lm42p/diy/docs/source/ElectricalPart/ElectricalPart.rst

.. # define a hard line break for HTML
.. |br| raw:: html

 <br />

=================
 Electrical Part
=================

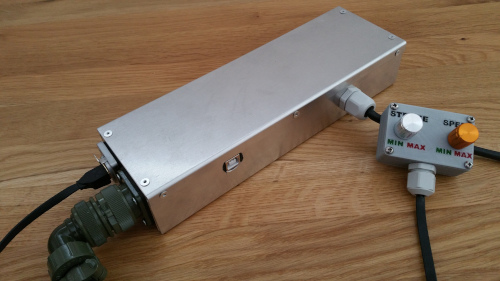
[picture p3: docs/source/ElectricalPart/figures/Power_Control_Unit_And_Remote-DIY-LM42P.jpg]

	    
Electrical Box
==============

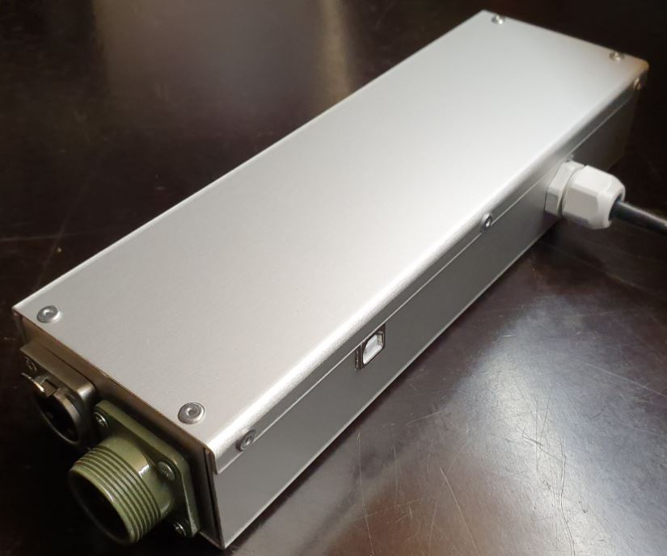
[picture p4: docs/source/ElectricalPart/figures/Electrical-Box-DIY-LM42P.jpg]


.. note::

   There is another Electrical Box which is about 130$ cheaper but
   15-20% slower and 40% less powerful (instead of 29 lbs thrust 17
   lbs) The Box is 3D printed. 

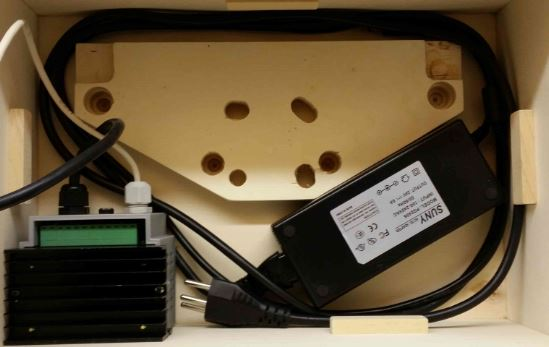
[picture p5: docs/source/ElectricalPart/figures/CheapElectricalBox/Cheap_Electrical_Box-DIY-LM42P.JPG]
    

   Driver : |CheapDriverAliexpress|

   .. |CheapDriverAliexpress| raw:: html

     <a href="https://www.aliexpress.com/item/32659074865.html?spm=a2g0s.9042311.0.0.27424c4dLziSPX"
     target="_blank">Cheap Driver Aliexpress</a>

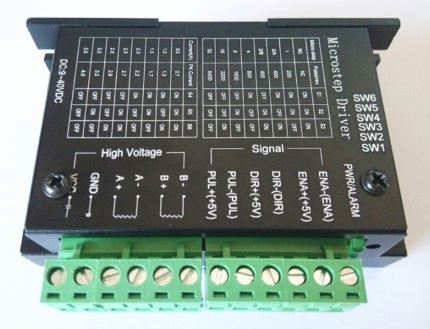
[picture p6: docs/source/ElectricalPart/figures/CheapElectricalBox/Cheap_Driver-Cheap-Electrical-Box-DIY-LM42P.JPG]
   

   Power 24V, 6A : |Power24V6AAliexpress|

   .. |Power24V6AAliexpress| raw:: html

     <a href="https://www.aliexpress.com/item/32589666765.html?spm=a2g0s.9042311.0.0.27424c4dOakSKw"
     target="_blank">Power 24V 6A Aliexpress</a>
     
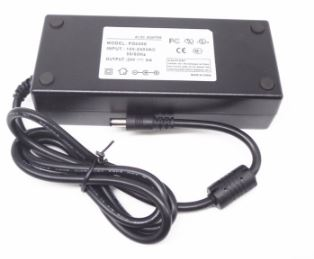
[picture p7: docs/source/ElectricalPart/figures/CheapElectricalBox/Cheap_Power_24V_6A-Cheap-Electrical-Box-DIY-LM42P.JPG]
   

Listing Parts
-------------

U Base
~~~~~~
- Quantity : 1x
- Material : anodized aluminium

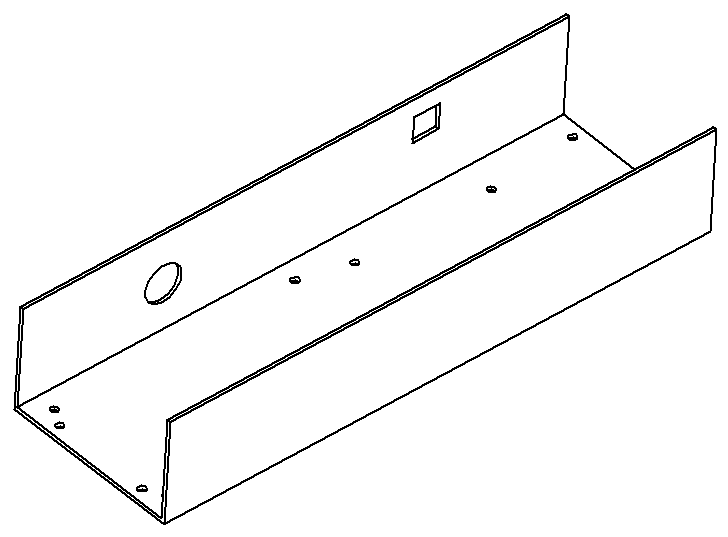
[picture p8: docs/source/ElectricalPart/figures/U_Base-3D-Electrical-Box-DIY-LM42P.PNG]


U Top
~~~~~
- Quantity : 1x
- Material : anodized aluminium

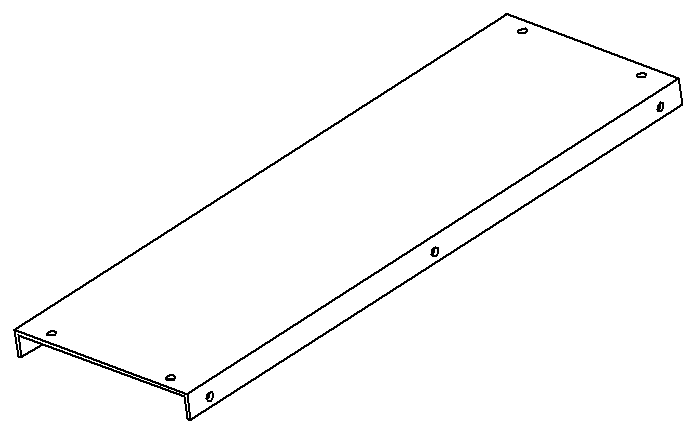
[picture p9: docs/source/ElectricalPart/figures/U_Top-3D-Electrical-Box-DIY-LM42P.PNG]


U Right
~~~~~~~
- Quantity : 1x
- Material : anodized aluminium

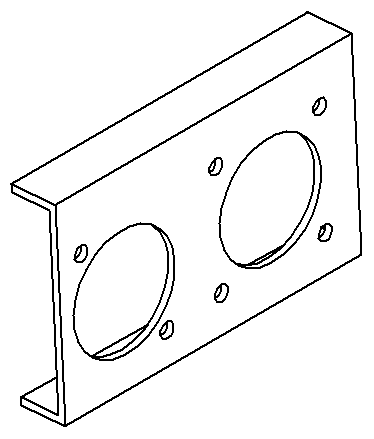
[picture p10: docs/source/ElectricalPart/figures/U_Right-3D-Electrical-Box-DIY-LM42P.PNG]


U Left
~~~~~~
- Quantity : 1x
- Material : anodized aluminium

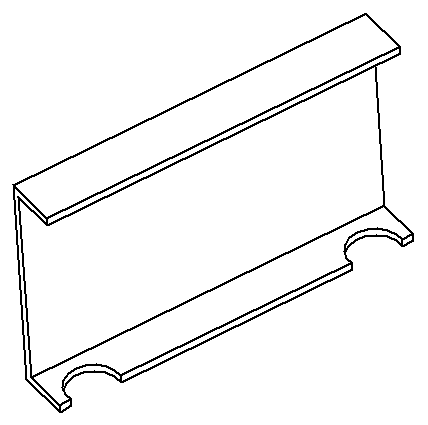
[picture p11: docs/source/ElectricalPart/figures/U_Left-3D-Electrical-Box-DIY-LM42P.PNG]

	    
Geckodrive G201X
~~~~~~~~~~~~~~~~
- Quantity : 1x

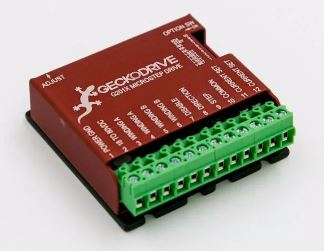
[picture p12: docs/source/ElectricalPart/figures/Geckodrive_G201X-Electrical-Box-DIY-LM42P.jpg]


Arduino Uno
~~~~~~~~~~~
- Quantity : 1x
  
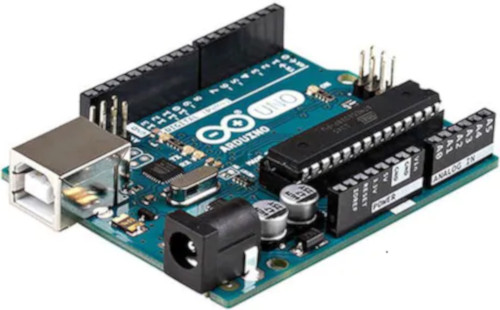
[picture p13: docs/source/ElectricalPart/figures/Arduino_Uno-DIY-LM42P.jpg]


Power 36V
~~~~~~~~~
- Quantity : 1x
  
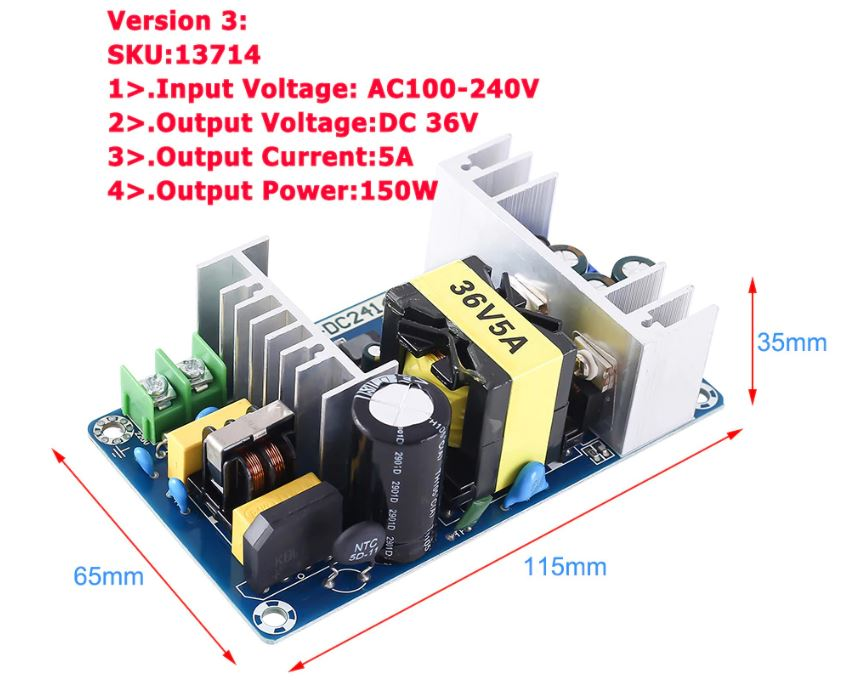
[picture p14: docs/source/ElectricalPart/figures/Power_36V-Electrical-Box-DIY-LM2P.jpg]


Power 36/12V
~~~~~~~~~~~~
- Quantity : 1x
- Type : LM2596

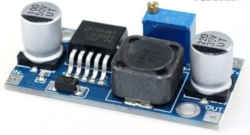
[picture p15: docs/source/ElectricalPart/figures/Power_36_12V-Electrical-Box-DIY-LM42P.JPG]


Connector Socket 5 pins Female Insert
~~~~~~~~~~~~~~~~~~~~~~~~~~~~~~~~~~~~~
- Quantity : 1x
  
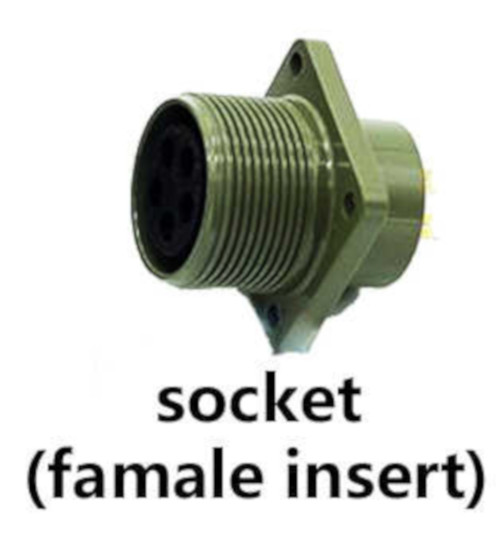
[picture p16: docs/source/ElectricalPart/figures/Socket_5_pins_Female_Insert-Electrical-Box-DIY-LM42P.jpg]


Plug RJ45
~~~~~~~~~
- Quantity : 1x
- Include : 2x screw M3, 2x nuts M3 and 2x spring washer
  
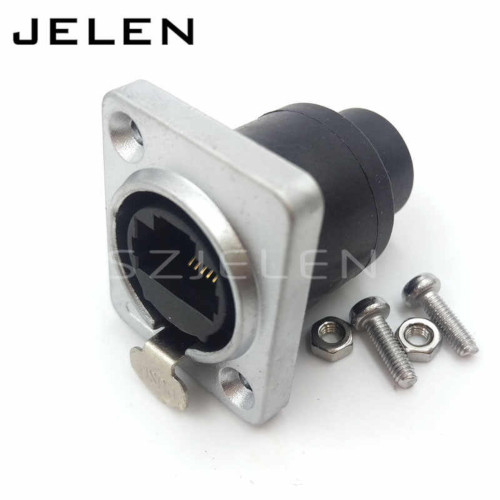
[picture p17: docs/source/ElectricalPart/figures/Plug_RJ45-Electrical-Box-DIY-LM42P.jpg]


Cable Gland
~~~~~~~~~~~
- Quantity : 1x
- Type : M16 4.5-10mm
- Include : 1x nuts M16  

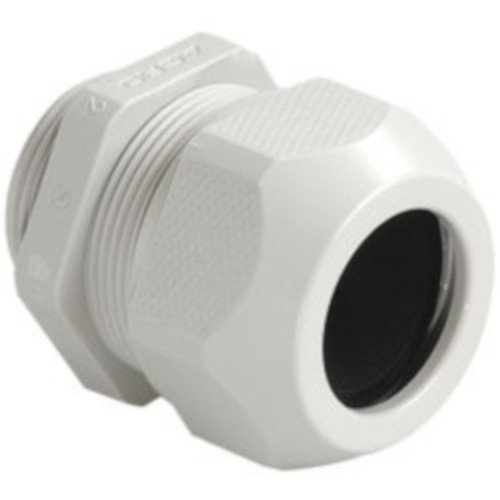
[picture p18: docs/source/ElectricalPart/figures/Cable_Gland_M16_4,5-10mm-Electrical-Box-DIY-LM42P.jpg]


Cable Ties
~~~~~~~~~~

- Quantity : 1x
- Purpose : To be sur that the **Cable Silicone 3 cores** can't be
  pull out

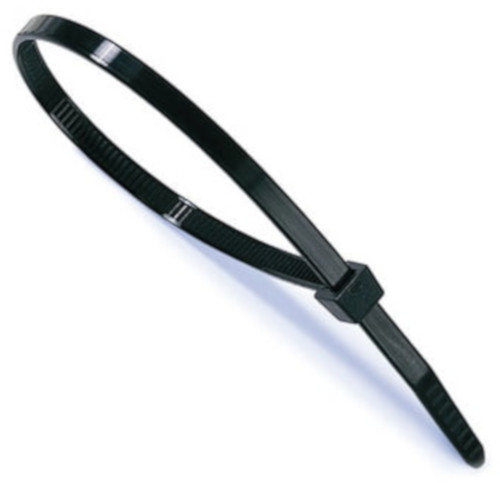
[picture p19: docs/source/ElectricalPart/figures/Cable_Ties-Electrical-Box-DIY-LM42P.jpg]


Cable Silicone 3 Cores
~~~~~~~~~~~~~~~~~~~~~~
- Length : 1x 2m
- Type : 0.75mm^2 
- Note : I used silicone because it's easy to fold.  
	    
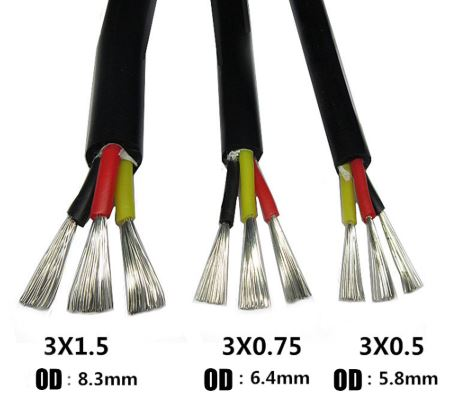
[picture p20: docs/source/ElectricalPart/figures/Cable_Silicone_3_Cores-Electrical-Box-DIY-LM42P.jpg]


Plug 110 / 220 V
~~~~~~~~~~~~~~~~

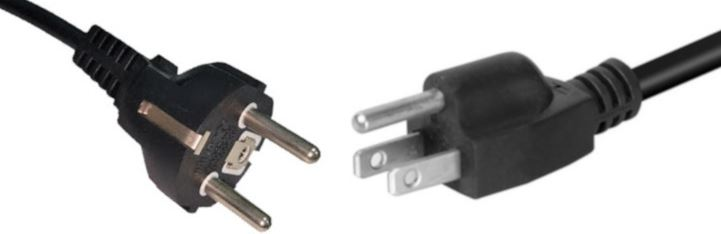
[picture p21: docs/source/ElectricalPart/figures/Plug_110_220V-Electrical-Box-DIY-LM42P.JPG]

	    
Male PCB PIN Header
~~~~~~~~~~~~~~~~~~~
- 1x 15 pins
- 1x 10 pins
- 1x 8 pins

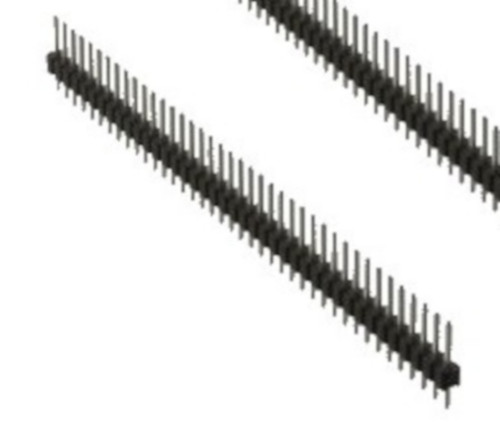
[picture p22: docs/source/ElectricalPart/figures/Male_PCB_PIN_Header-DIY-LM42P.jpg]


Connector RJ45
~~~~~~~~~~~~~~
- Quantity : 1x
- Length : 15cm  

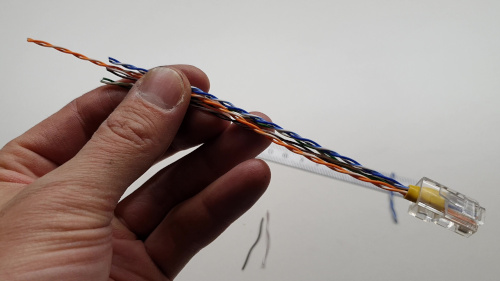
[picture p23: docs/source/ElectricalPart/figures/Connector_RJ45_length_15cm-DIY-LM42P.jpg]


Ground Terminal M3
~~~~~~~~~~~~~~~~~~
- Quantity : 1x

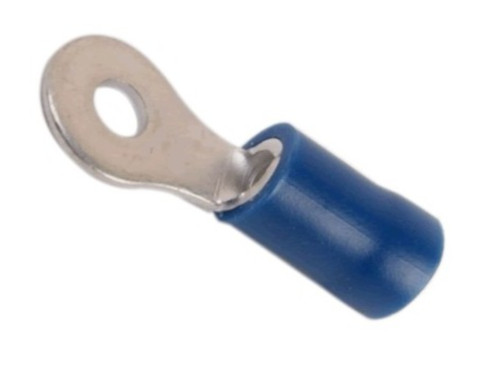
[picture p24: docs/source/ElectricalPart/figures/Ground_Terminal_M3-Electrical-Box-DIY-LM42P.jpg]

	    
Capacitor Polarized 1uF
~~~~~~~~~~~~~~~~~~~~~~~
- Quantity : 1x
- Purpose : This reduce the noise while reading the speed on the
  remote-control

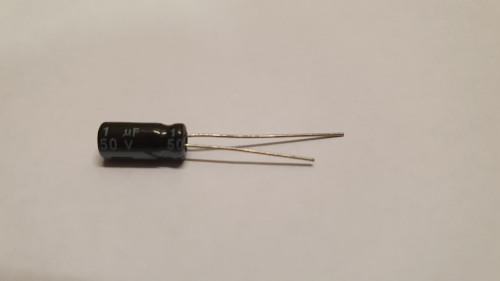
[picture p25: docs/source/ElectricalPart/figures/Capacitor_1uf_polarized-Electrical-Box-DIY-LM42P.jpg]


Spacer 6-8-3mm
~~~~~~~~~~~~~~
- Quantity : 4x
- Material : aluminium

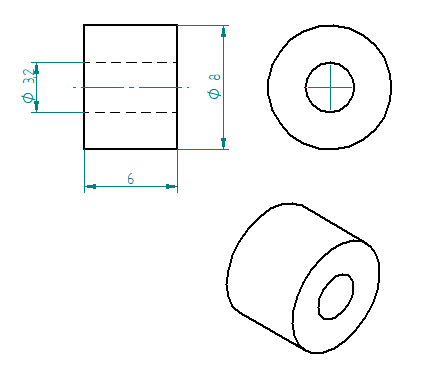
[picture p26: docs/source/ElectricalPart/figures/Spacer_6_8_3mm-Electrical-Box-DIY-LM42P.PNG]


Square 10-12-9mm
~~~~~~~~~~~~~~~~
- Quantity : 2x
- Material : aluminium
- Purpose : Reinforcement of the fixaton (glue) of the **Arduino Uno**
  to the **U Base**   

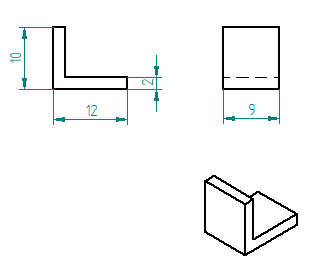
[picture p27: docs/source/ElectricalPart/figures/Square_10_12_9-Electrical-Box-DIY-LM42P.PNG]


Countersunk Head Screw M3 x 8mm
~~~~~~~~~~~~~~~~~~~~~~~~~~~~~~~
- Quantity : 4x
- Material : Stainless Steel
- Purpose : To fix **Geckodrive** on the **U Base**
  
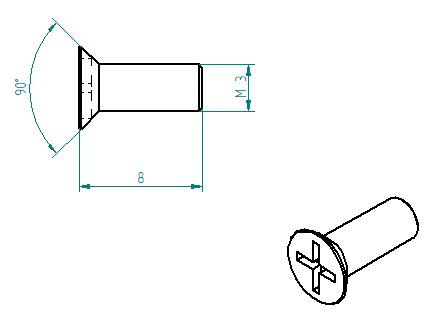
[picture p28: docs/source/ElectricalPart/figures/Countersunk_Head_Screw_M3x8mm-DIY-LM42P.PNG]

	    
Countersunk Head Screw M3 x 12mm
~~~~~~~~~~~~~~~~~~~~~~~~~~~~~~~~
- Quantity : 4x
- Material : Stainless Steel
- Purpose : To fix the **Connector Socket 5 pins Female Insert** on
  the **U Right** 
  
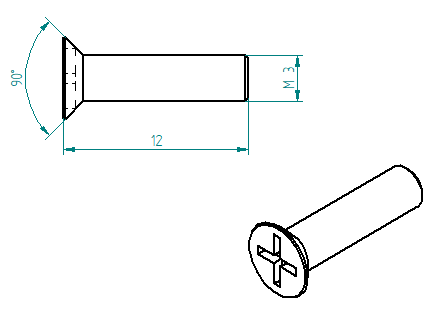
[picture p29: docs/source/ElectricalPart/figures/Countersunk_Head_Screw_M3x12mm-DIY-LM42P.PNG]

	    
Countersunk Head Screw M3 x 14mm
~~~~~~~~~~~~~~~~~~~~~~~~~~~~~~~~
- Quantity : 3x
- Material : Stainless Steel
- Purpose : To fix the **Power 36V** on the **U Base**  

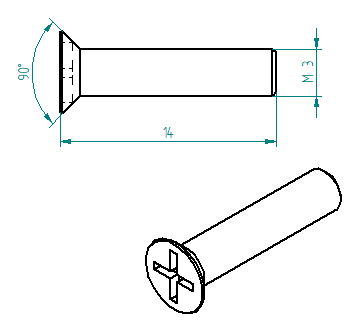
[picture p30: docs/source/ElectricalPart/figures/Countersunk_Head_Screw_M3x14mm-DIY-LM42P.PNG]


Countersunk Head Screw M3 x 16mm
~~~~~~~~~~~~~~~~~~~~~~~~~~~~~~~~
- Quantity : 1x
- Material : Stainless Steel
- Purpose : To fix the **Power 36V** also the **Ground Terminal** on
  the **U Base**  

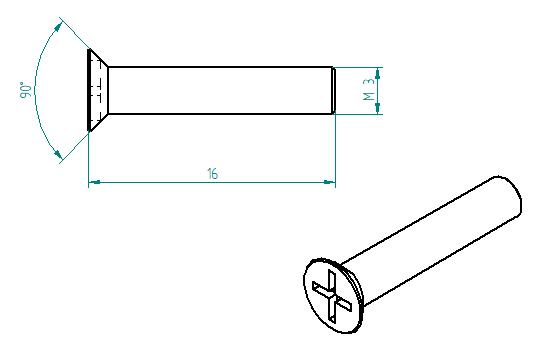
[picture p31: docs/source/ElectricalPart/figures/Countersunk_Head_Screw_M3x16mm-DIY-LM42P.PNG]


Washer M3
~~~~~~~~~
- Quantity : 12x

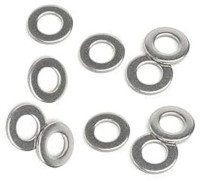
[picture p32: docs/source/ElectricalPart/figures/Washer_M3-Electrical-Box-DIY-LM42P.jpg]


Nuts M3
~~~~~~~
- Quantity : 12x

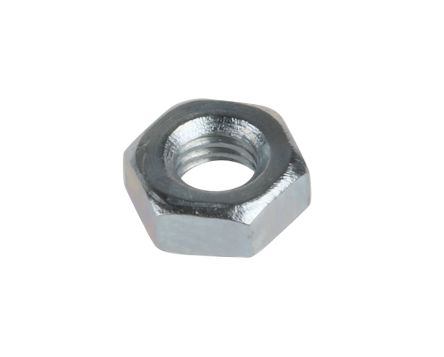
[picture p33: docs/source/ElectricalPart/figures/Nuts_M3-Electrical-Box-DIY-LM42P.jpg]


Rivet
~~~~~
- Quantity : 14x
- Type : diameter 3mm, length 6mm  
- Material : Stainless Steel

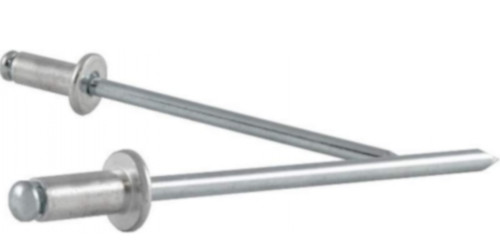
[picture p34: docs/source/ElectricalPart/figures/Rivet_3mm_length_6mm-Electrical-Box-DIY-LM42P.jpg]

	    
Glue Silicone
~~~~~~~~~~~~~
- Quantity : 1x
- Type : Polyflex 444
- Purpose : To glue the **Arduino Uno** to the **U Base** using the
  **Square 10-12-9mm** to fix stronger
  
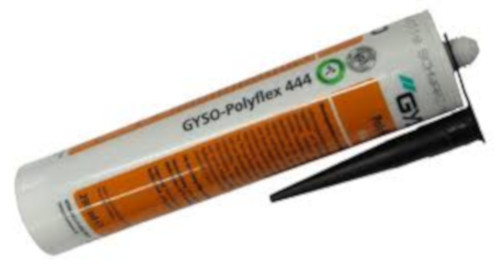
[picture p35: docs/source/ElectricalPart/figures/Glue_Mastic_Polyflex_444-Electrical-Box-DIY-LM42P.jpg]


Threadlocker Glue
~~~~~~~~~~~~~~~~~
- Quantity : 1x
- Type : Loctite 243
- Purpose : To glue the **Nuts M3**
  
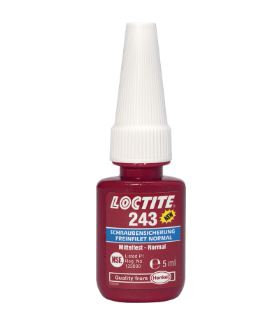
[picture p36: docs/source/ElectricalPart/figures/Threadlocker_Glue-Electrical-Box-DIY-LM42P.JPG]


Operation Plan
--------------

Make The Sheets Parts
~~~~~~~~~~~~~~~~~~~~~

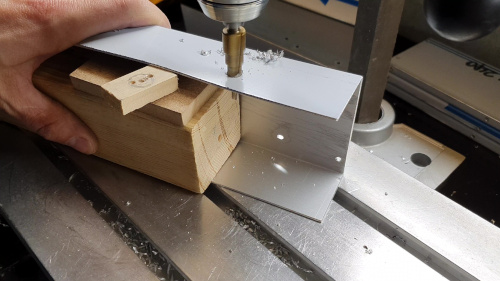
[picture p37: docs/source/ElectricalPart/figures/Make_The_Sheets_Parts-Electrical-Box-DIY-LM42P.jpg]

	    
Make the **U Base**, **U Right** and the **U Left** following this
**Video**, see also the drawings below : 

.. raw:: html

    <iframe width="350" height="245"
    src="https://www.youtube.com/embed/RGeVY6nWUIQ?start=0&end=1078"
    frameborder="0" 
    allowfullscreen></iframe>

|br|

**Drawings** :

Material : aluminium

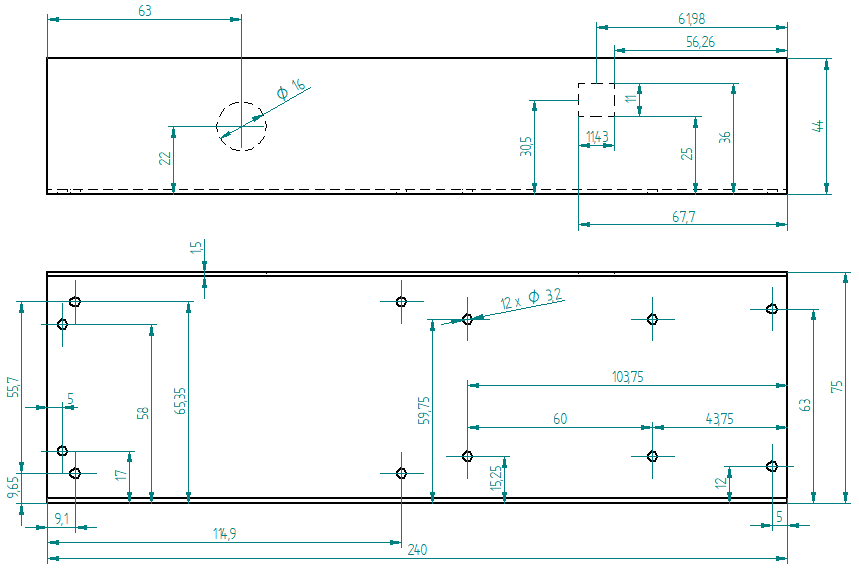
[picture p38: docs/source/ElectricalPart/figures/U_Base-Drawing-Electrical-Box-DIY-LM42P.PNG]


    U Base

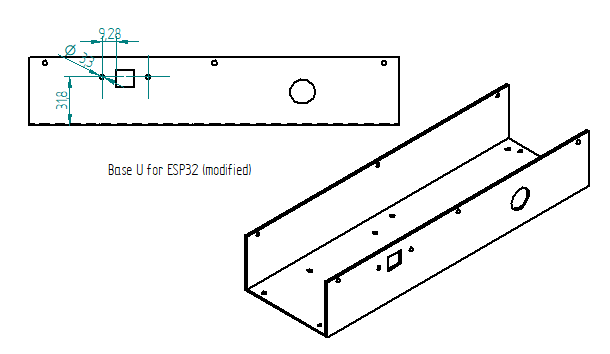
[picture p39: docs/source/ElectricalPart/figures/UbaseESP32Modified/UBaseESP32Modified.PNG]


    U Base ESP (modified)    

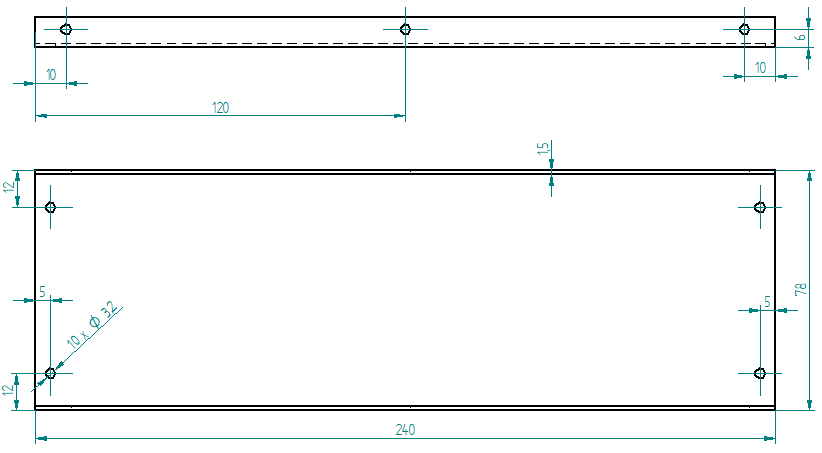
[picture p40: docs/source/ElectricalPart/figures/U_Top-Drawing-Electrical-Box-DIY-LM42P.PNG]


    U Top

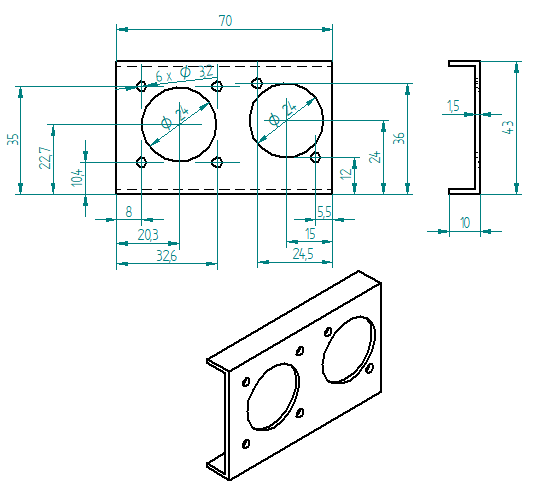
[picture p41: docs/source/ElectricalPart/figures/U_Right-Drawing-Electrical-Box-DIY-LM42P.PNG]


    U Right

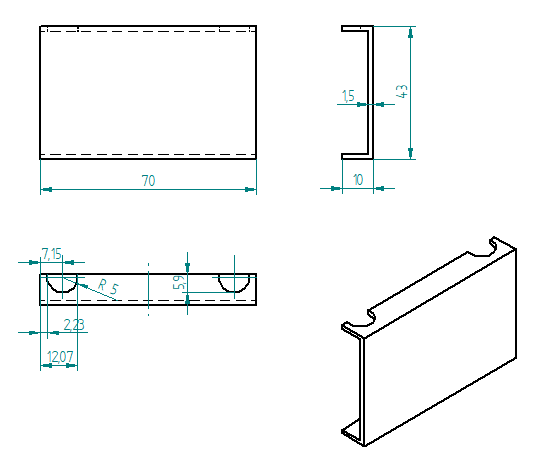
[picture p42: docs/source/ElectricalPart/figures/U_Left-Drawing-Electrical-Box-DIY-LM42P.PNG]


    U Left   

Make the Spacer 6-8-3mm
~~~~~~~~~~~~~~~~~~~~~~~
See the following video :

.. raw:: html

    <iframe width="350" height="245"
    src="https://www.youtube.com/embed/RGeVY6nWUIQ?start=1025&end=1275"
    frameborder="0" 
    allowfullscreen></iframe>

|br|

**Drawing** :

- Quantity : 4x
- Material : aluminium



    Spacer 6-8-3mm

Make the Square 10-12-9mm
~~~~~~~~~~~~~~~~~~~~~~~~~
See the following video :

.. raw:: html

    <iframe width="350" height="245"
    src="https://www.youtube.com/embed/RGeVY6nWUIQ?start=1276&end=1356"
    frameborder="0" 
    allowfullscreen></iframe>

|br|

**Drawing** :

- Quantity : 2x
- Material : aluminium



    Square 10-12-9mm        

Scrape the surface on the U Base
~~~~~~~~~~~~~~~~~~~~~~~~~~~~~~~~

File the bottom of the **U Base** (only the part where the red framed
hole is) so that the grounding contact faces well. This operation is
not necessary if you are using non anodized sheets.

.. note:: The anodized surfaces are not
	  conductive.  

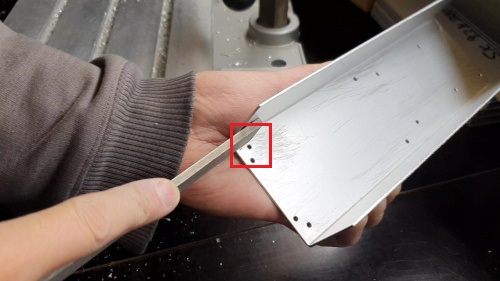
[picture p43: docs/source/ElectricalPart/figures/Scrape_Surface_U_Base-Electrical-Box-DIY-LM42P.jpg]


See Video :

.. raw:: html

    <iframe width="350" height="245"
    src="https://www.youtube.com/embed/RGeVY6nWUIQ?start=152&end=173"
    frameborder="0" 
    allowfullscreen></iframe>

|br|

Control Power 36V
~~~~~~~~~~~~~~~~~
Control the voltage of the output of the Power 36V with a
voltmeter. It should be 36V.

Adjust voltage Power 36/12V
~~~~~~~~~~~~~~~~~~~~~~~~~~~

**Materials:**

* 1 wire 0.5mm^2 red length = 120mm
* 1 wire 0.5mm^2 red length = 150mm
* 1 wire 0.5mm^2 black length = 140mm
* 1 wire 0.5mm^2 black length = 60mm

1) Sold the wire

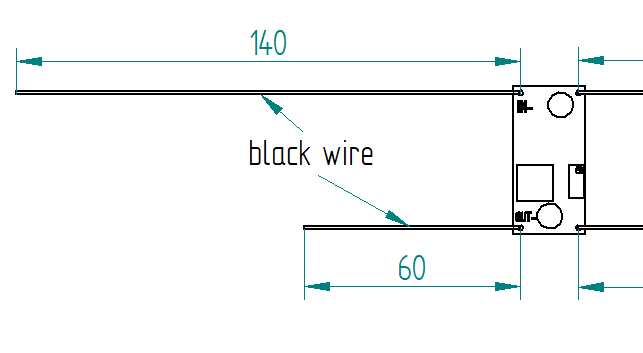
[picture p44: docs/source/ElectricalPart/figures/Power36_12V-Black-Wired-Electrical-Box-LM42P.PNG]


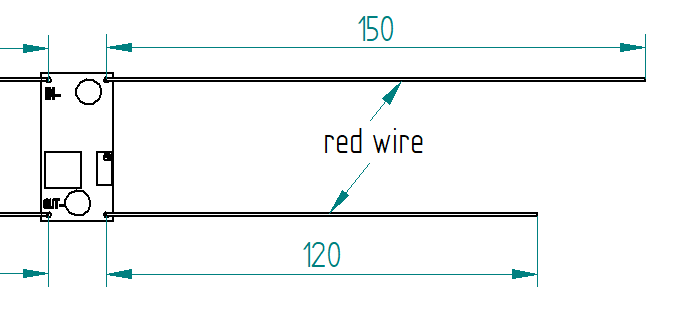
[picture p45: docs/source/ElectricalPart/figures/Power36_12V-Red-Wired-Electrical-Box-LM42P.PNG]


2) Wire the Power 36/12V

 - Connect the Power 36/12V IN  to the Power 36V OUT
 - Connect the voltmeter to Power 36/12V OUT

3) Adjust the voltage

 With a *Screwdriver 0*, adjust the voltage to 12V

Fix the Power Cable to the Electrical Box
~~~~~~~~~~~~~~~~~~~~~~~~~~~~~~~~~~~~~~~~~

See Video :

.. raw:: html

    <iframe width="350" height="245"
    src="https://www.youtube.com/embed/RGeVY6nWUIQ?start=1355&end=1581"
    frameborder="0" 
    allowfullscreen></iframe>

#. Strip the **Cable Silicone 3 Cores** at 10cm 
#. Fix the **Cable Gland** to the **U Base**
#. Tighten **Cable Gland**
#. Tighten the **Cable Ties** and cut it with a *Cutting Pliers*
#. Tighten the **Ground Terminal M3** on the ground wire (yellow)
#. Tighten the Phase and Neutre to **Power 36V** "IN"

Set Geckodrive current limit
~~~~~~~~~~~~~~~~~~~~~~~~~~~~

This operation limits the current so that the motor will not overheat.
I tested with 5A and it looks like the motor is a bit overheaten. But
thats ok if the machine is used less than about 10min. To be sure the
motor is not overheaten I recommand to set the current at 4.2Amps.

- For G203V :

  Connect a resistor of 120kOhms between pin 11 and 12 of the 
  GECKODRIVE. This will limit MOTOR current by 5A. (for 4.2A please
  refer to datasheet)

- For G201X :

  - if machine used for less than 10min set to 5A

    set the switches like the following figure

    

  - if machine used more than 10min set to 4.2A

    set the switches like the following figure

    
   
Screw the Power 36V and Geckodrive on the U Base
~~~~~~~~~~~~~~~~~~~~~~~~~~~~~~~~~~~~~~~~~~~~~~~~

.. note:: Use **Threadlocker Glue**.

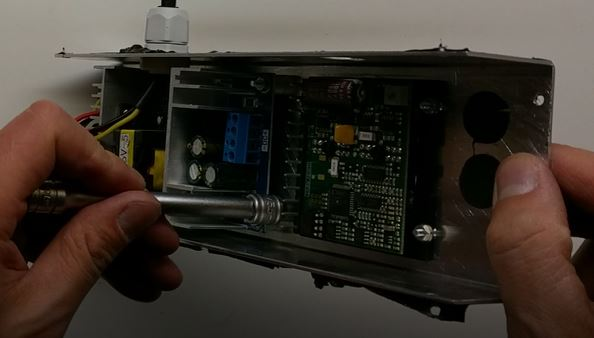
[picture p46: docs/source/ElectricalPart/figures/Fix_Power36V_Gecko-Electrical-Box-DIY-LM42P.jpg]


- For Power 36V :
  
  #. Fix three corners of the **Power 36V** by using :
       * 3x **Spacer 6-8-3mm**
       * 3x **Countersunk Head Screw M3 x 14mm**
       * 3x **Washer M3**
       * 3x **Nuts M3**
  #. Fix the last corner : The ground to the U Base by using : 
       * 1x **Countersunk Head Screw M3 x 16mm**
       * 1x **Washer M3**
       * 1x **Nuts M3**
       * 1x **Ground Terminal M3** (the ground on the **Cable Silicone 3
         Cores** 

    =========  ===================    
    Power 36V  U Base
    =========  ===================
    GROUND     screw with *Spacer*
    =========  ===================

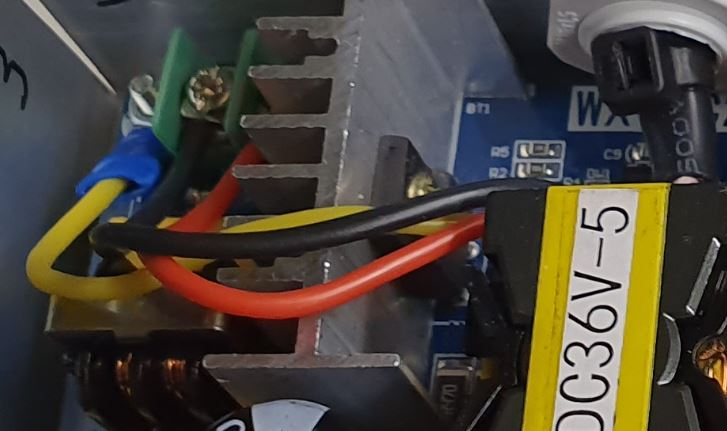
[picture p47: docs/source/ElectricalPart/figures/Power36V_Ground_Electrical-Box-DIY-LM42P.jpg]
    
  
- For Geckodrive use :

  - 4x **Head Screw M3 x 8mm**
  - 4x **Washer M3**
  - 4x **Nuts M3**

Glue the Power 36/12V and Arduino Uno
~~~~~~~~~~~~~~~~~~~~~~~~~~~~~~~~~~~~~

Glue the **Arduino Uno** at the **U Base** with **Glue Silicone** and
**Square 10-12-9mm** and the **Power 36/12V**. 
 
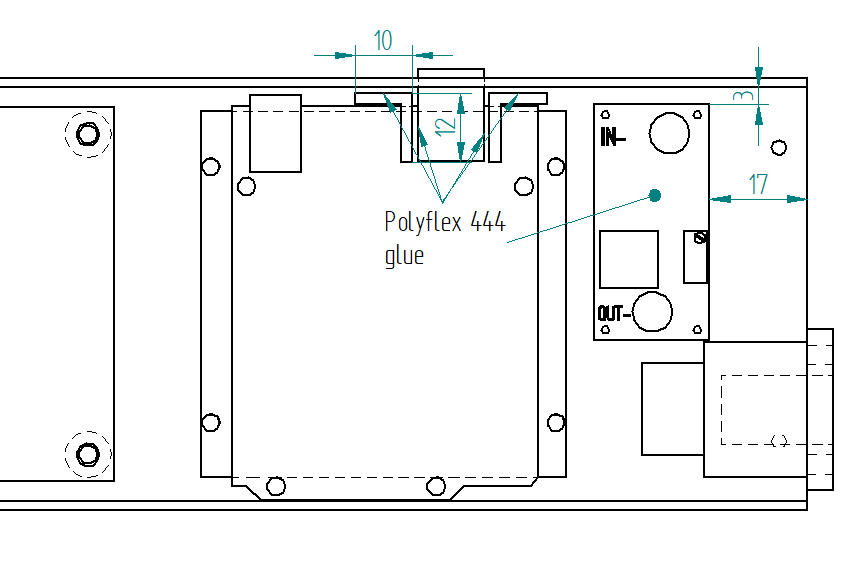
[picture p48: docs/source/ElectricalPart/figures/Glue_Power36_12V_Arduino-Electrical-Box-DIY-LM42P.PNG]


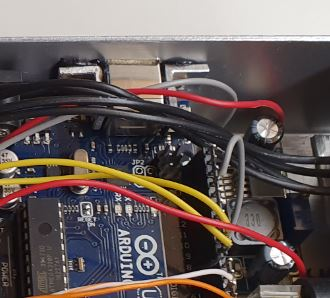
[picture p49: docs/source/ElectricalPart/figures/Glue_Power36_12V_Arduino-Electrical-Box-DIY-LM42P.jpg]


Wiring
~~~~~~
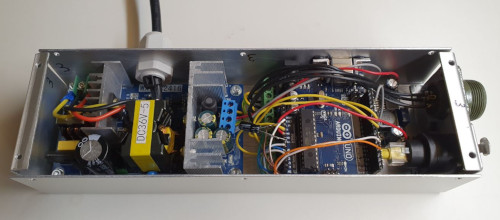
[picture p50: docs/source/ElectricalPart/figures/Electrical_Box_Open-DIY-LM42P.jpg]


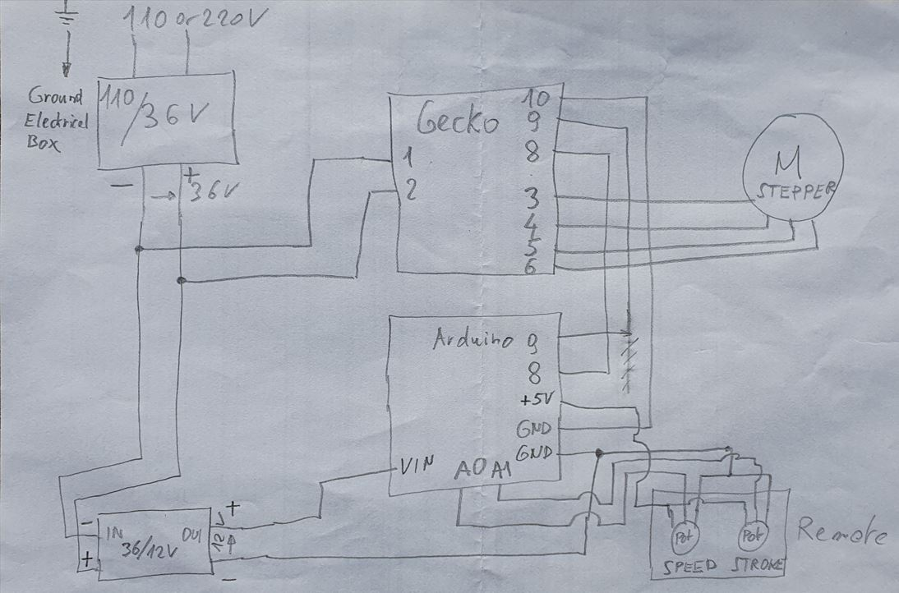
[picture p51: docs/source/ElectricalPart/figures/Shagmatic-Arduino-Gecko-LM42P.JPG]


See video :

.. raw:: html

    <iframe width="350" height="245"
    src="https://www.youtube.com/embed/RGeVY6nWUIQ?start=1581&end=1806"  
    frameborder="0" 
    allowfullscreen></iframe>
    
|br|

1. Sold the wires to the **Male PCB PIN Header** (15, 10, 8 pins),
   except the POWER 36/12V OUT+ 

   Use two clamps this help to sold the **Male PCB PIN Header**

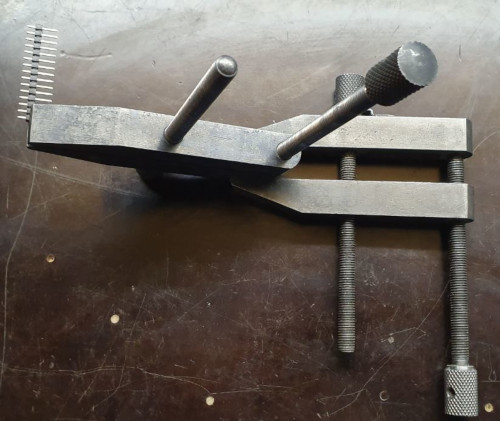
[picture p52: docs/source/ElectricalPart/figures/Clamps_Sold-Electrical-Box-DIY-LM42P.jpg]


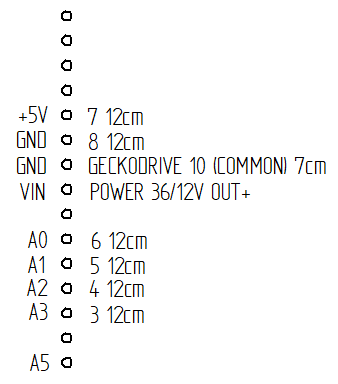
[picture p53: docs/source/ElectricalPart/figures/Male_PCB_PIN_Header_15Pins-Electrical-Box-DIY-LM42P.PNG]


 Male PCB PIN Header 15 pins
	 
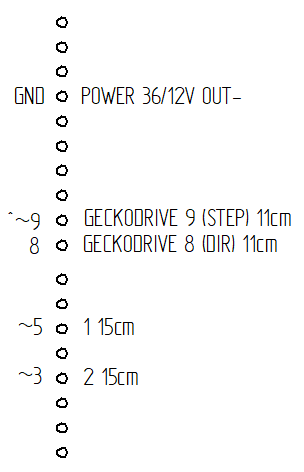
[picture p54: docs/source/ElectricalPart/figures/Male_PCB_PIN_Header_10_8Pins-Electrical-Box-DIY-LM42P.PNG]


 Male PCB PIN Header 10 and 8 pins
	 
===========  =======  ============
GECKODRIVE   ARDUINO  Cable Length
===========  =======  ============
8 (DIR)      PIN 8    11cm
9 (STEP)     PIN 9    11cm
10 (COMMON)  GND       7cm
===========  =======  ============

============  =======  ============
POWER 36/12V  ARDUINO  Cable Length
============  =======  ============
OUT-          GND      6cm
OUT+          VIN      12cm
============  =======  ============

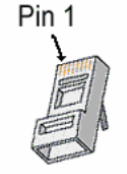
[picture p55: docs/source/ElectricalPart/figures/RJ45_Show_Pin1-Electrical-Box-DIY-LM42P.png]


============  =======================  ============
ARDUINO       RJ45 cable (inside Box)  Cable Length
============  =======================  ============
A0            6 sold capacitor +       12cm     
A1            5                          "
A2            4                          "
A3            3                          "
\~3           2                        15cm 
~5            1                          " 
GND           8 sold capacitor -       12cm
\+5V          7                          "
============  =======================  ============

2. Sold the Capacitor between A0 and GND (8) see folowing picture

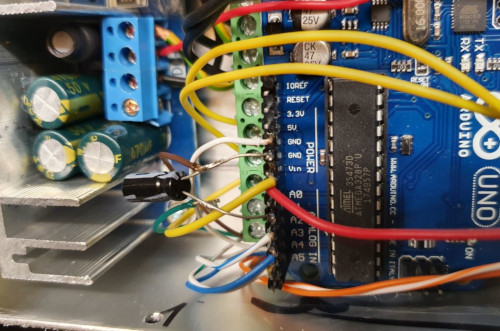
[picture p56: docs/source/ElectricalPart/figures/Sold_Capacitor-Electrical-Box-DIY-LM42P.jpg]


3. Connect :

=========  ================  ============
Power 36V     GECKODRIVE     Cable Length
=========  ================  ============
\-DC       1 (POWER GND)     6cm
D+         2 (18 TO 80 VDC)   "
=========  ================  ============

=========  ============  ============
Power 36V  POWER 36/12V  Cable Length            
=========  ============  ============
\-DC       IN-           14cm 
DC+        IN+           15cm  
=========  ============  ============

=================  ========================  ============
GECKODRIVE         Female Connector (MOTOR)  Cable Length
=================  ========================  ============
3 (WINDING A)      A                         15cm
4 (WINDING not A)  B                          "
5 (WINDING B)      C                          "
6 (WINDING not B)  D                          "
=================  ========================  ============

Upload the programm to **Arduino Uno** and final control
~~~~~~~~~~~~~~~~~~~~~~~~~~~~~~~~~~~~~~~~~~~~~~~~~~~~~~~~
#. Plug the PC using an USB cable to the Electrical-Box
#. Upload the programm (soon available)
#. Control if every thing is ok (the ***Machine**, **Remote Control**,
   **Stepper Motor** and the **Rod** should be done). Do all these
   steps showed in that video for the test :  

   .. raw:: html

    <iframe width="350" height="245"
    src="https://www.youtube.com/embed/VgY4AlmjkgQ"
    frameborder="0" 
    allowfullscreen></iframe>
#. Cover with **U Top** and **Rivet**
    
Remote Control
==============

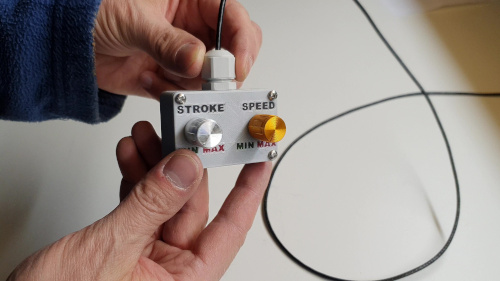
[picture p57: docs/source/ElectricalPart/figures/Remote-Control/Remote_Control_And_Wire_Remote-Control-DIY-LM42P.jpg]


Listing Parts
-------------

Box
~~~
- Quantity : 1x
- 3D Printed in PLA  

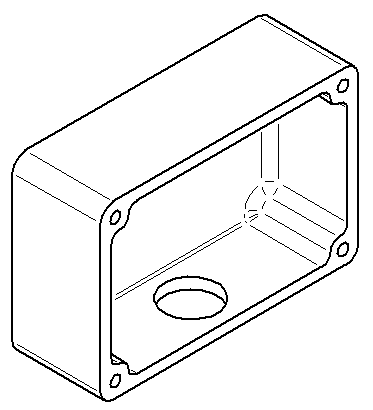
[picture p58: docs/source/ElectricalPart/figures/Remote-Control/Box-3D-Remote-Control-Box-DIY-LM42P.png]


Cover
~~~~~
- Quantity : 1x
- 3D Printed in PLA  

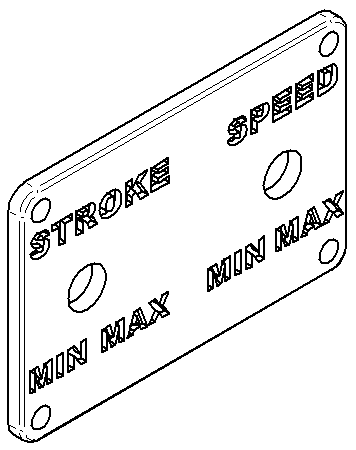
[picture p59: docs/source/ElectricalPart/figures/Remote-Control/Cover-3D-Remote-Control-Box-DIY-LM42P.png]


Potentiometer
~~~~~~~~~~~~~
- Quantity : 2x
- Type : 10k

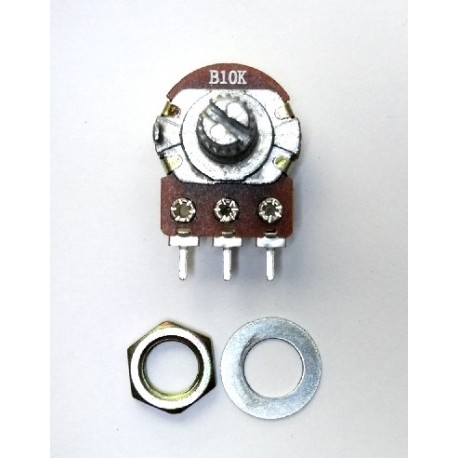
[picture p60: docs/source/ElectricalPart/figures/Remote-Control/Potentiometer_R10k-Remote-Control-Box-DIY-LM42P.jpg]

	    
Potentiommeter Knobs
~~~~~~~~~~~~~~~~~~~~
- Quantity : 1x Grey (stroke), 1x Gold (speed)
  
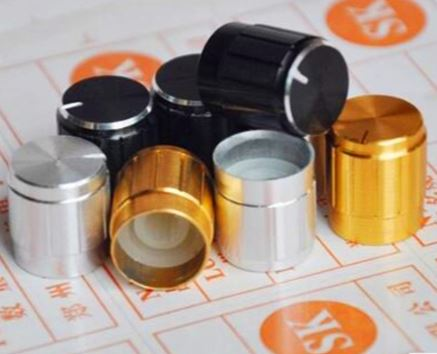
[picture p61: docs/source/ElectricalPart/figures/Remote-Control/Potentiometer_Knobs-Remote-Control-Box-LM42P.JPG]


RJ45 Cable
~~~~~~~~~~
- Quantity : 1x
- Length : 2.5m  
- Type : Ultrafine

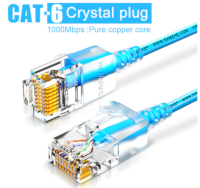
[picture p62: docs/source/ElectricalPart/figures/Remote-Control/RJ45_Cable-Remote-Control-Box-DIY-LM42P.PNG]

	    	    
Cable Gland M12
~~~~~~~~~~~~~~~
- Quantity : 1x
- Type : M12 3-6mm

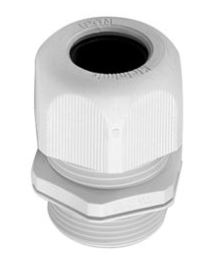
[picture p63: docs/source/ElectricalPart/figures/Remote-Control/Cable_Gland_M12-Remote-Control-Box-DIY-LM42P.JPG]


Epoxy
~~~~~
- Resin and Hardener

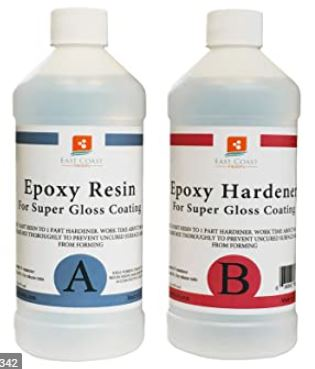
[picture p64: docs/source/ElectricalPart/figures/Remote-Control/Epoxy_Resin-Remote-Control-Box-DIY-LM42P.JPG]


Pigment Epoxy
~~~~~~~~~~~~~
- Quantity : 1x color black, 1x color red, 1x color green

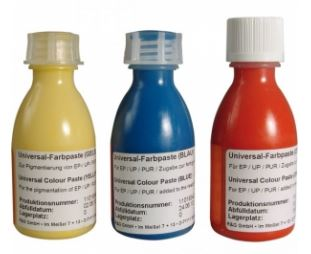
[picture p65: docs/source/ElectricalPart/figures/Remote-Control/Pigments_Epoxy-Remote-Control-Box-DIY-LM42P.JPG]


Cable Ties
~~~~~~~~~~

- Quantity : 1x
- Purpose : To be sur that the **RJ45 Cable** can't be
  pull out



Screw
~~~~~
- Quantity : 4x
- Diameter : 2.9mm
- Length : 13mm
- Stainless steel

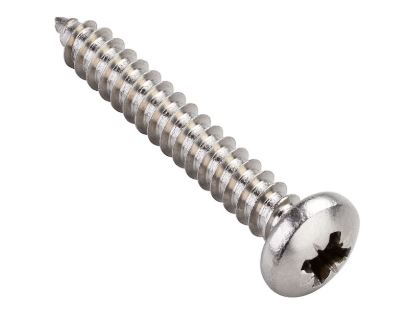
[picture p66: docs/source/ElectricalPart/figures/Remote-Control/Scew_2_9_13-Remote-Control-Box-DIY-LM42P.JPG]


Operation Plan
--------------
See the video :

.. raw:: html

    <iframe width="350" height="245"
    src="https://www.youtube.com/embed/wxmEBM34qhU"
    frameborder="0" 
    allowfullscreen></iframe>

|br|

Make the Box
~~~~~~~~~~~~
Print it in PLA.
Infill = 50%
File : soon available...

Make the Cover
~~~~~~~~~~~~~~
1. Print it in PLA.
   Infill = 50%
   File : soon available...  
2. Prepare the **Epoxy** with black pigment, red pigment and green
   pigment 
3. Fill with pigmented Epoxy the inscriptions on the **Cover**

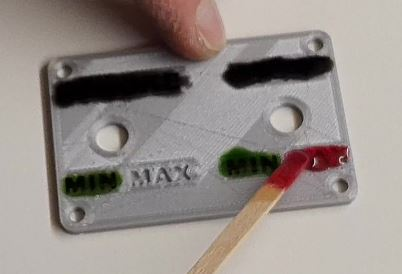
[picture p67: docs/source/ElectricalPart/figures/Remote-Control/Fill_Inscriptions_Pigmented_Epoxy-Remote-Control-Box-DIY-LM42P.JPG]
     
	   
4. Cure the **Epoxy** then sand it very thin (60, 240, 400)
5. Place the **Potentiometer** (2x) and and tighten them   

Wiring the Remote Control
~~~~~~~~~~~~~~~~~~~~~~~~~
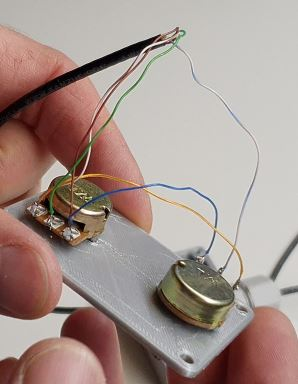
[picture p68: docs/source/ElectricalPart/figures/Remote-Control/Wire-Remote-Control-Box-DIY-LM42P.JPG]


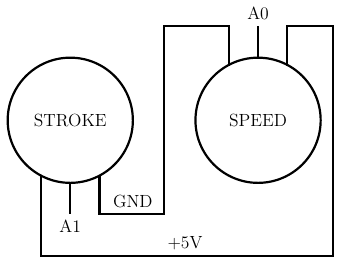
[picture p69: docs/source/ElectricalPart/figures/Remote-Control/Remote_Control_Box_Wiring-Remote-Control-Box-DIY-LM42P.png]


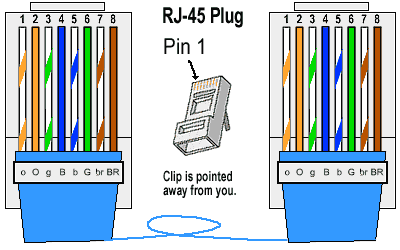
[picture p70: docs/source/ElectricalPart/figures/Remote-Control/Standard_Ethernet_Cable_RJ45.gif]

	   
==============  ===========  ============
Remote-Control   RJ45 cable   Wire Color
==============  ===========  ============
A0              6            G
A1              5            b
GND             8            BR
\+5V            7            br
==============  ===========  ============

#. Strip the **RJ45 Cable** at 7cm
#. Cut the unused wire
#. Use the cutted unused wire to make the bridge between GRD and +5V
   inside the Remote Control

Motor
=====

This section shows how to fix the **Cable Silicone 4 Cores** to the **Connector
Plug 5 pins Male Insert** and the **Motor**

Listing Parts
-------------

Motor
~~~~~
- Quantity : 1x
- Type : Stepper Motor NEMA 23 23HS11240
- Length : 112mm
- 4.2A  

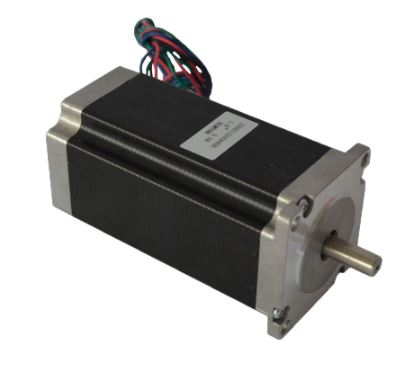
[picture p71: docs/source/ElectricalPart/figures/Motor/Stepper_Motor_23HS11240-Motor-DIY-LM42P.JPG]


Connector Plug 5 pins Male Insert
~~~~~~~~~~~~~~~~~~~~~~~~~~~~~~~~~
- Quantity : 1x

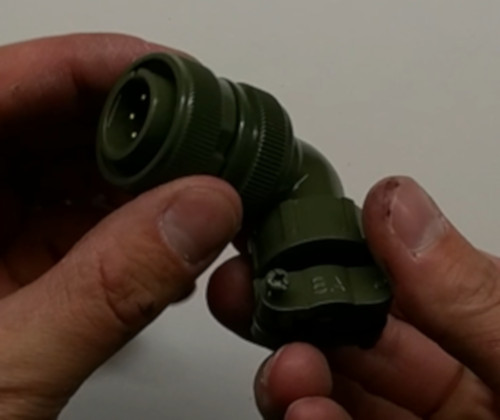
[picture p72: docs/source/ElectricalPart/figures/Motor/Connector_Plug_5_pins_Male_Insert-Electrical-Box-DIY-LM42P.jpg]


Cable Silicone 4 Cores
~~~~~~~~~~~~~~~~~~~~~~
- Quantity : 2.2m
- 0.75 mm^2  

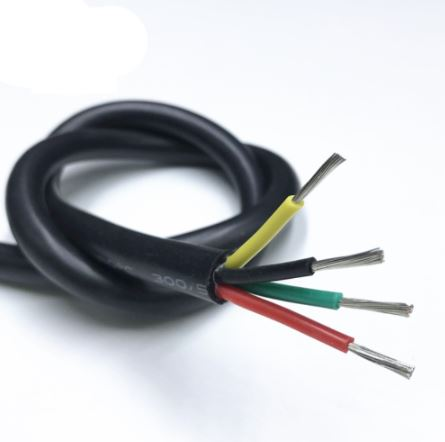
[picture p73: docs/source/ElectricalPart/figures/Motor/Cable_Silicone_4_Cores-Motor-DIY-LM42P.jpg]


Tube Cable Holder
~~~~~~~~~~~~~~~~~
- Quantity : 1x
- Material : Aluminium  

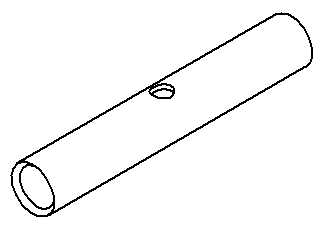
[picture p74: docs/source/ElectricalPart/figures/Motor/Tube_Cable_Holder-Motor-DIY-LM42P.PNG]


Heat Shrink Tube
~~~~~~~~~~~~~~~~
- Quantity : 4x - Length : 13mm
- Quantity : 1x - Length : 37mm


  
Screw Hex Head Allen M5 x 40
~~~~~~~~~~~~~~~~~~~~~~~~~~~~
If the **Motor** isn't fixed yet on the **Machine**, then 1x Screw is
needed.

- Quantity : 1x
- Size : M5 x 40  
- Type : Stainless Allen Bolt Socket Cap Screw Hex Head Allen Key
  DIN912 

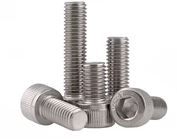
[picture p75: docs/source/ElectricalPart/figures/Motor/Screw_Hex_Head_Allen_M5x40-Motor-DIY-LM42P.JPG]

	    
Glue Silicone
~~~~~~~~~~~~~
- Quantity : 1x
- Type : Polyflex 444
  


Cable Ties
~~~~~~~~~~

- Quantity : 1x



Connect the Connector Plug 5 pins Male Insert
---------------------------------------------
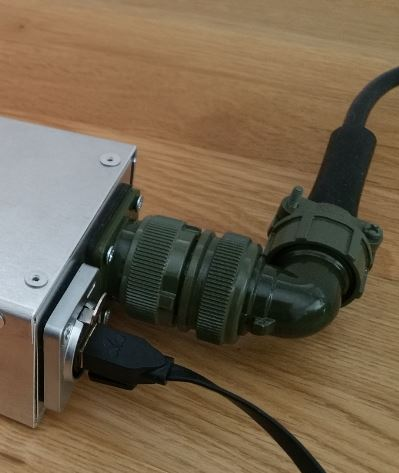
[picture p76: docs/source/ElectricalPart/figures/Motor/Connector_Plug_5_pins_Male_Insert-Motor-DIY-LM42P.JPG]


Operation Plan
~~~~~~~~~~~~~~
See the video :

.. raw:: html

    <iframe width="350" height="245"
    src="https://www.youtube.com/embed/GfWPj4LcxXg?start=0&end=97"
    frameborder="0" 
    allowfullscreen></iframe>

|br|

Wiring

#. strip the cable at 3cm
#. strip the 4 wires and solder the wires
#. 5cm from the edge roll up the 10-layers adhesive tape
#. pass the cable and solder the wires in the plug in
   counter-clockwise order 
   
   * black (A)
   * yellow (B)
   * red (C)
   * green (D)

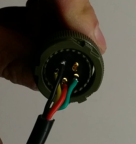
[picture p77: docs/source/ElectricalPart/figures/Motor/Wires_Plug-Motor-DIY-LM42P.png]
   
	    
#. assemble the plug and tighten the flange

Connect and fix the Cable Silicone 4 Cores to the Motor
-------------------------------------------------------
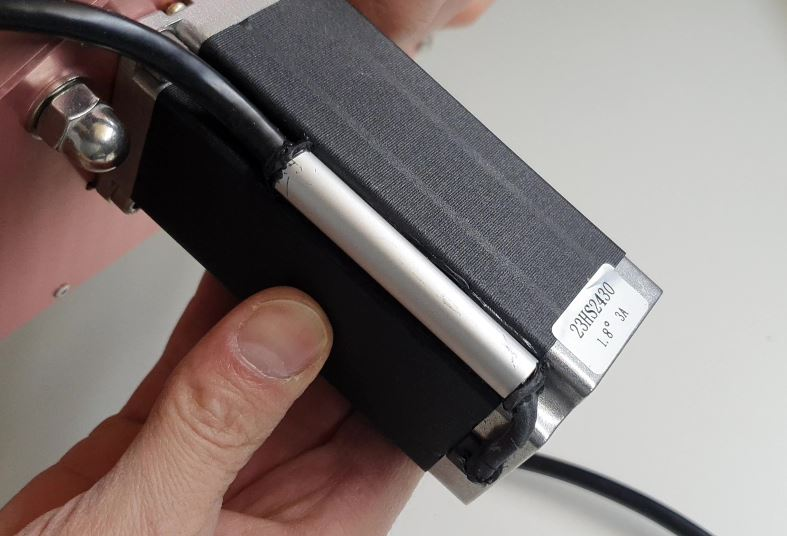
[picture p78: docs/source/ElectricalPart/figures/Motor/Connect_Motor_Cable-DIY-LM42P.jpg]


Operation Plan
~~~~~~~~~~~~~~
See the video :

.. raw:: html

    <iframe width="350" height="245"
    src="https://www.youtube.com/embed/GfWPj4LcxXg?start=97&end=417"
    frameborder="0" 
    allowfullscreen></iframe>

|br|	    

#. Make the **Tube Cable Holder**

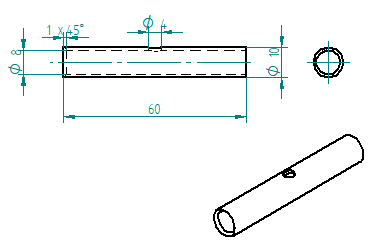
[picture p79: docs/source/ElectricalPart/figures/Motor/Tube_Cable_Holder-Drawing-Motor-DIY-LM42P.PNG]
   

     Tube Cable Holder (material aluminium anodized)

#. Unpacking and motor control. Plug the 4 wires on an **Electrical
   Box** and make it turn. This is important before making the
   following steps.
#. There are two kinds of motor a 3A and a 4.2A each motor has their own
   colors of wire. Depend on the Amps of the motor you use, cut the
   wire as follow :
   
   #. Motor 3A :
      
      - red wire 47mm
      - yellow 57mm
      - blue 67mm
      - green 77mm
	
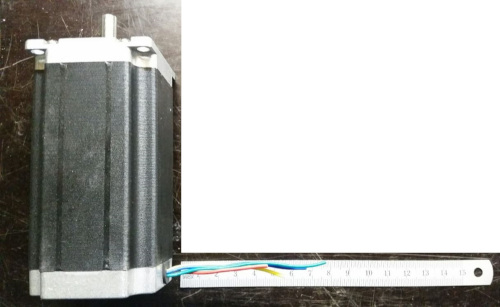
[picture p80: docs/source/ElectricalPart/figures/Motor/Cut_Motor_Wire-Motor-DIY-LM42P.jpg]
      

	3A motor with wires cutted 

   #. Motor 4.2A :
      
      - red 47mm
      - green 57mm
      - black 67mm
      -	blue 77mm
	
#. Stripping, twisting, tinning the motor wires to 5mm
#. Cut the **Heat Shrink Tube** to 37mm length and tighten it with
   industrial foehn. The red wire should protrude about 5mm..     
#. Cut the **Cable Silicone 4 Cores** at 2.2m
#. Strip the **Cable Silicone 4 Cores** to 45mm.
#. Cut the wires on the **Cable Silicone 4 Cores** as follow:
   - red 40mm
   - yellow 30mm
   - black 20mm
   - green 10mm
#. Strip, twist, tin-plate the cable wires to 5mm.
#. Cut 4x **Heat Shrink Tube** at 13mm
#. Put 13mm **Heat Shrink Tube** + **Tube Cable Holder** (pay
   attention to direction the chamfer 1x45) and solden
#. Degrease **Tube Cable Holder**, **Cable Silicone 4 Cores** and
   **Motor** with acetone 

   .. warning::
      
     If the **Motor** isn't fixed on the machine yet, then don't
     forget to put the screw in the motor hole (see picture below) 

#. Inject the **Glue Silicone** through the 4mm hole diam.
   until it comes out of both sides of the **Tube Cable Holder**; take
   the surplus and apply it to the **Motor** on the groove where the
   **Screw Hex Head Allen M5 x 40** has been placed; 
   turn the **Tube Cable Holder** so that the injection hole is
   against the **Motor** and is not visible; put a **Cable Ties** on
   the **Cable Silicone 4 Cores** , put the **Tube Cable Holder** on  
   with the clamp see following picture
   
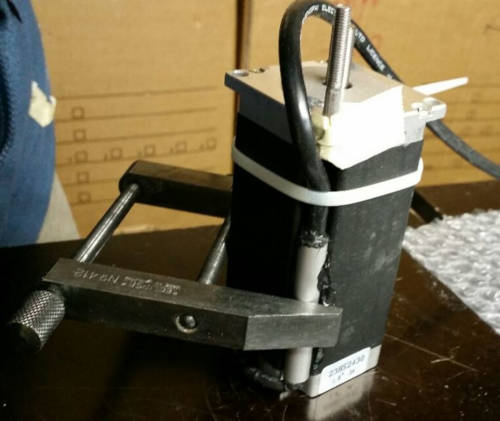
[picture p81: docs/source/ElectricalPart/figures/Motor/Fix_Motor_Cable-Motor-DIY-LM42P.jpg]
   
	    
   if necessary, inject at the end of the **Tube Cable Holder** where
   the chamfer is located and put some **Glue Silicone** on the
   **Motor** if you see the wires that protrude a little beyond the
   **Heat Shrink Tube** 
#. Allow to harden; clean and remove the beads on **Tube Cable
   Holder**.
