lm42p/diy/docs/source/Machine/Machine.rst

=======
Machine
=======

Static Parts
------------

Casing
^^^^^^

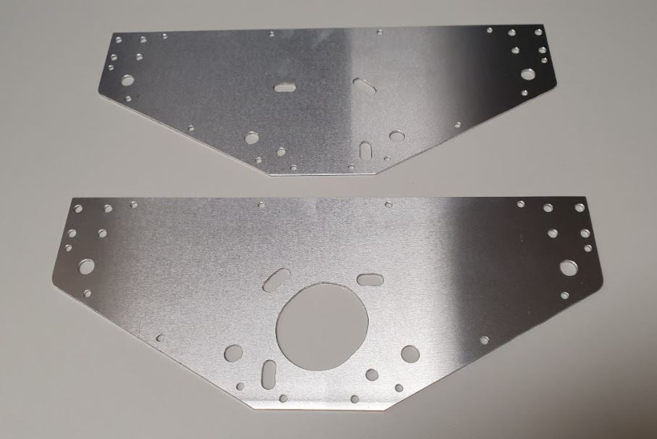
[picture p84: docs/source/Machine/figures/Casing-Pic-Machine-DIY-LM42P.JPG]


Video
'''''
This video shows how to make the Casing and the Casing Motor Side

.. raw:: html

    <iframe width="350" height="245"
    src="https://www.youtube.com/embed/knJyQPlPn18"
    frameborder="0" 
    allowfullscreen></iframe>

Casing
''''''

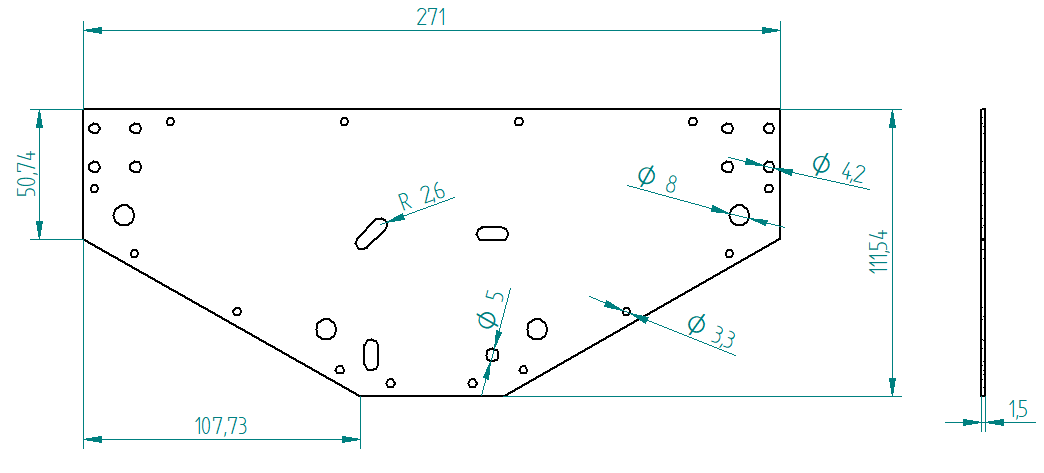
[picture p85: docs/source/Machine/figures/Casing-Machine-DIY-LM42P.PNG]


Casing Motor Side
'''''''''''''''''

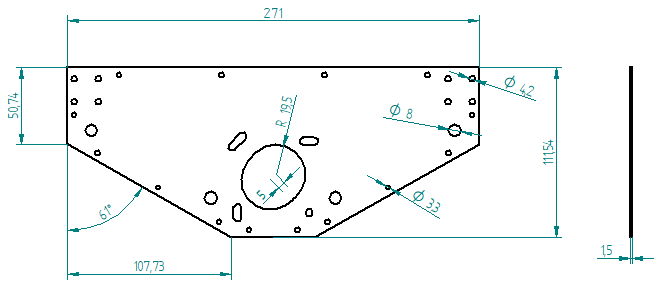
[picture p86: docs/source/Machine/figures/Casing_Motor_Side-Machine-DIY-LM42P.PNG]


Jig Casing
''''''''''

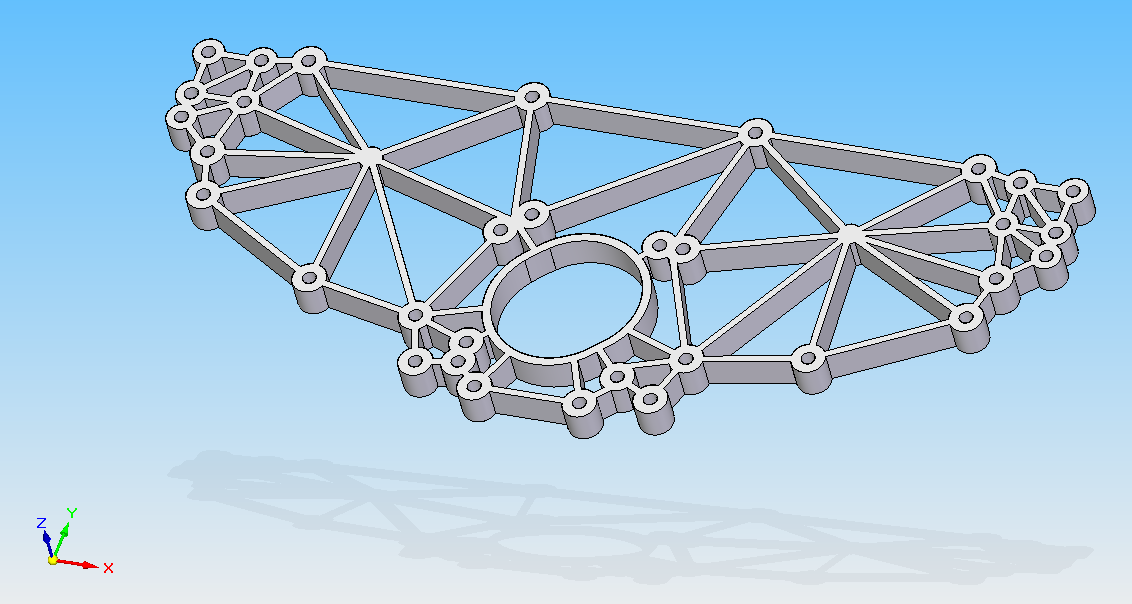
[picture p87: docs/source/Machine/figures/Jig_Casing-3DModel-Machine-DIY-LM42P.PNG]

       
- STL file -> |JigCasingSTL|

.. |JigCasingSTL| raw:: html

  <a href="https://www.thingiverse.com/thing:4719536/files"
  target="_blank">Jig Casing STL</a>

- Drill Bush (to be hunted in jig) material : brass 

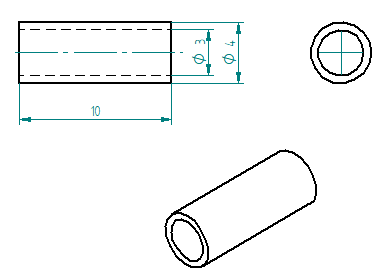
[picture p88: docs/source/Machine/figures/DrillBush.PNG]
  
  
Frame
^^^^^

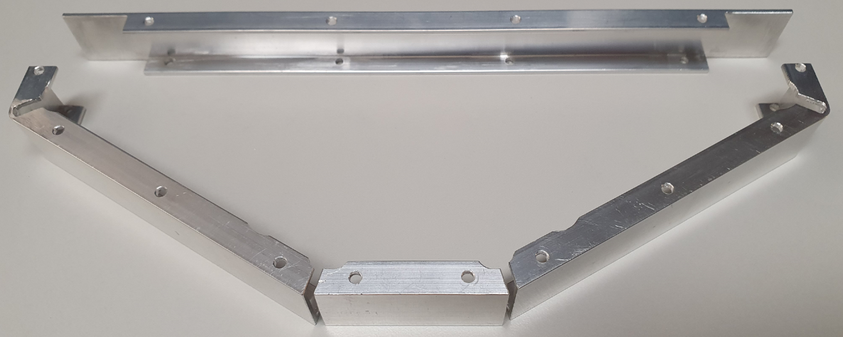
[picture p89: docs/source/Machine/figures/Frame-Pic-Machine-DIY-LM42P.JPG]


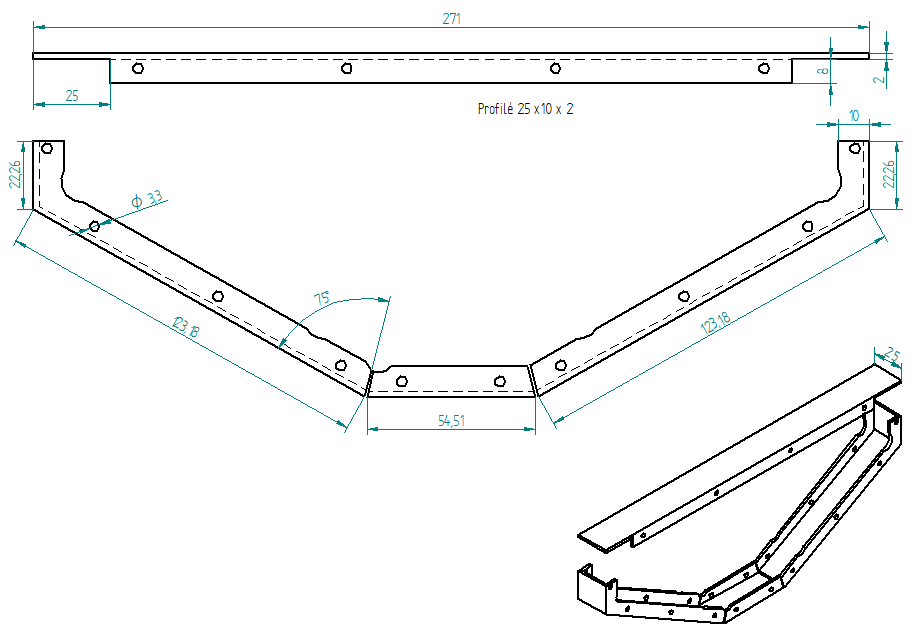
[picture p90: docs/source/Machine/figures/Frame-Machine-DIY-LM42P.PNG]


Video
'''''

This video shows how to make the Frame :

.. raw:: html

    <iframe width="350" height="245"
    src="https://www.youtube.com/embed/J1oeEkLgkek"
    frameborder="0" 
    allowfullscreen></iframe>

Large Frame
'''''''''''

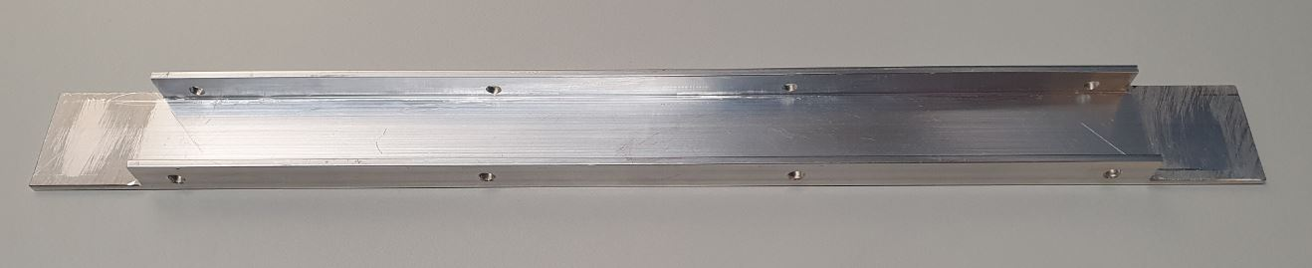
[picture p91: docs/source/Machine/figures/Large_Frame-Pic-Machine-DIY-LM42P.JPG]


**Jig Drill Large Frame**

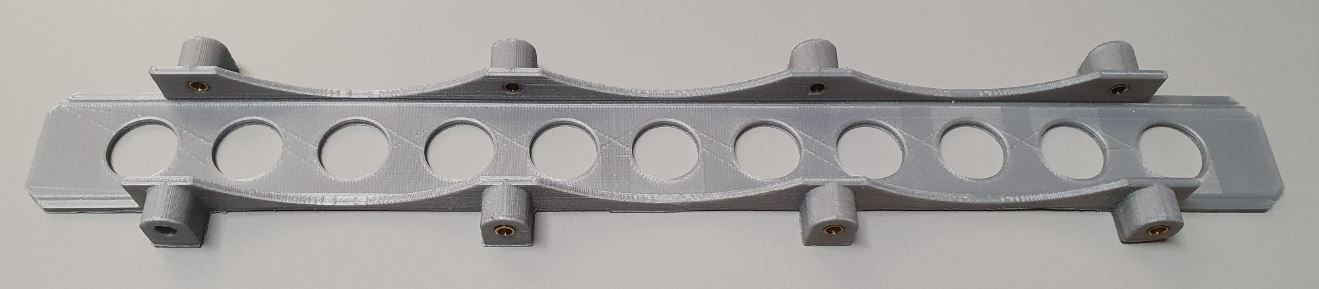
[picture p92: docs/source/Machine/figures/Jig_Drill_Large_Frame-Pic-Machine-DIY-LM42P.JPG]
  

STL file -> |JigDrillLargeFrameSTL|

.. |JigDrillLargeFrameSTL| raw:: html

  <a href="https://www.thingiverse.com/thing:4722636/files"
  target="_blank">Jig Drill Large Frame STL</a>	       

Medium Frame
''''''''''''

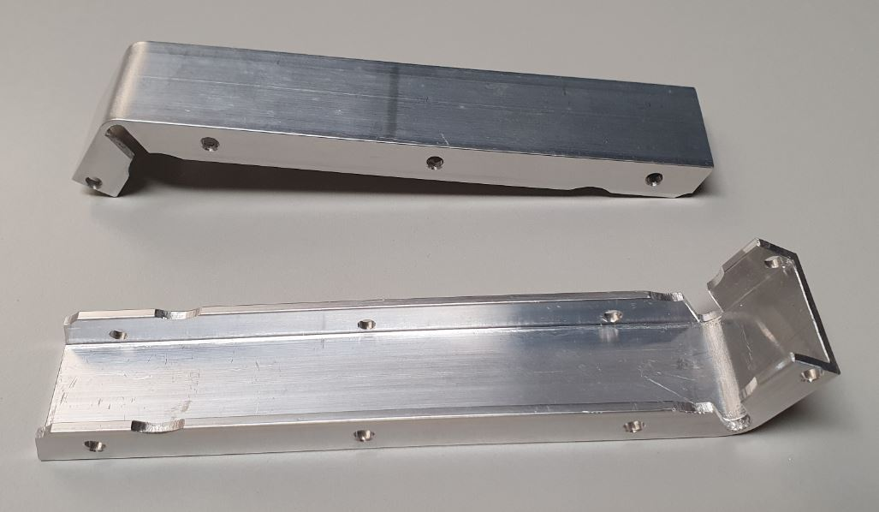
[picture p93: docs/source/Machine/figures/Medium_Frame-Pic-Machine-DIY-LM42P.JPG]


**Jig Drill Medium Frame**

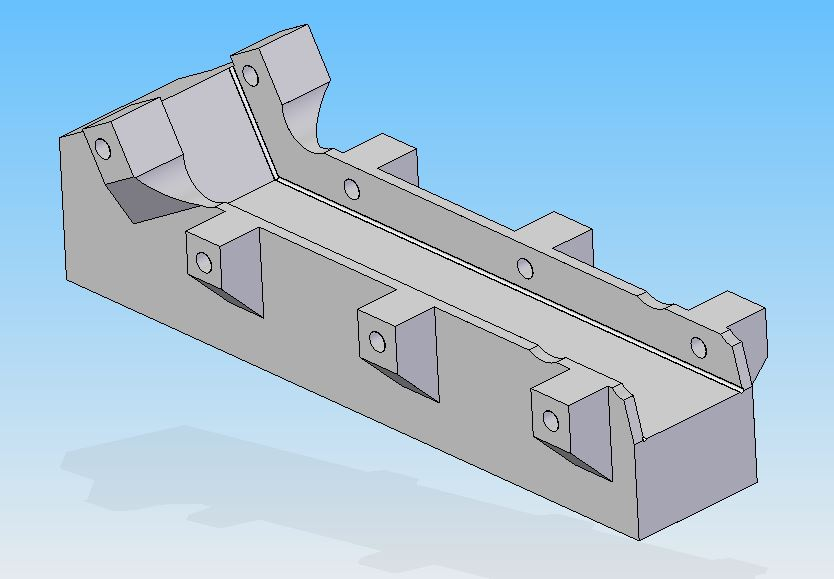
[picture p94: docs/source/Machine/figures/Jig_Drill_Medium_Frame-Pic-Machine-DIY-LM42P.JPG]
  

STL file -> |JigDrillMediumFrameSTL|

.. |JigDrillMediumFrameSTL| raw:: html

  <a href="https://www.thingiverse.com/thing:4723118/files"
  target="_blank">Jig Drill Medium Frame STL</a>

**Jig Bend Medium Frame**

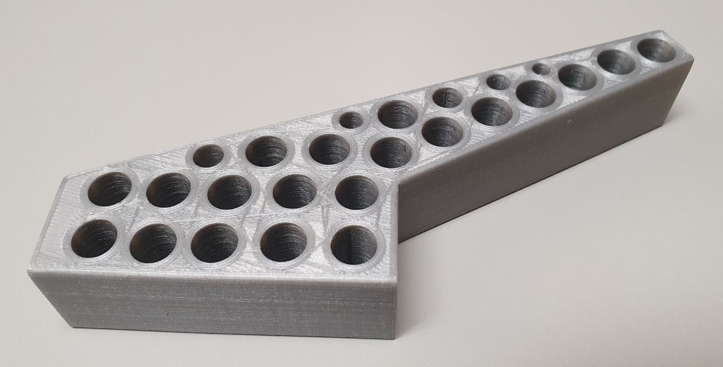
[picture p95: docs/source/Machine/figures/Jig_Bend_Medium_Frame-Pic-Machine-DIY-LM42P.JPG]
  

STL file -> |JigBendMediumFrameSTL|

.. |JigBendMediumFrameSTL| raw:: html

  <a href="https://www.thingiverse.com/thing:4723155/files"
  target="_blank">Jig Bend Medium Frame STL</a>

**Angle Gauge Medium Frame**

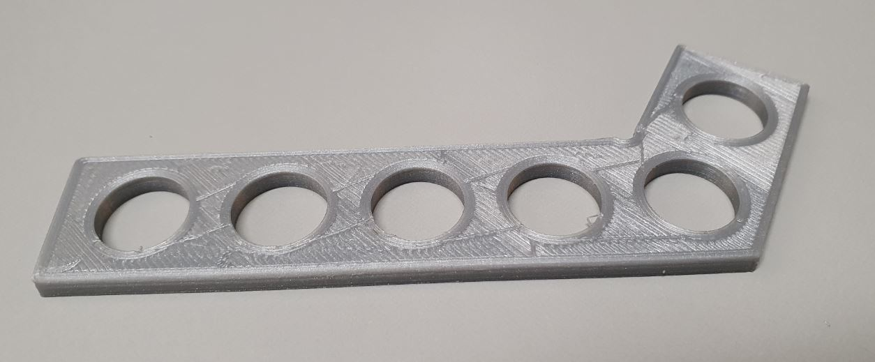
[picture p96: docs/source/Machine/figures/Angle_Gauge_Medium_Frame-Pic-Machine-DIY-LM42P.JPG]
  

STL file -> |AngleGaugeMediumFrameSTL|

.. |AngleGaugeMediumFrameSTL| raw:: html

  <a href="https://www.thingiverse.com/thing:4723181/files"
  target="_blank">Angle Gauge Medium Frame STL</a>    

Small Frame
'''''''''''

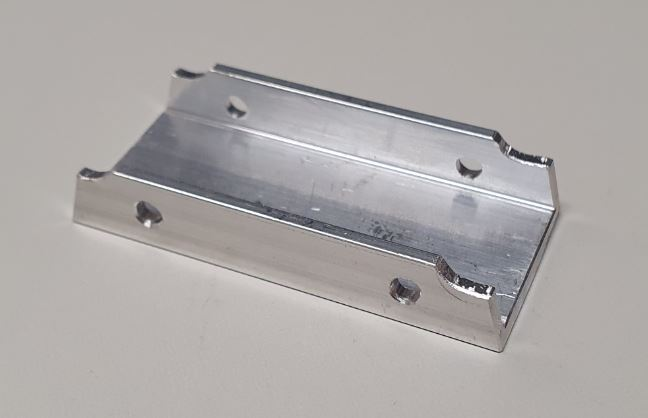
[picture p97: docs/source/Machine/figures/Small_Frame-Pic-Machine-DIY-LM42P.JPG]


**Jig Drill Small Frame**

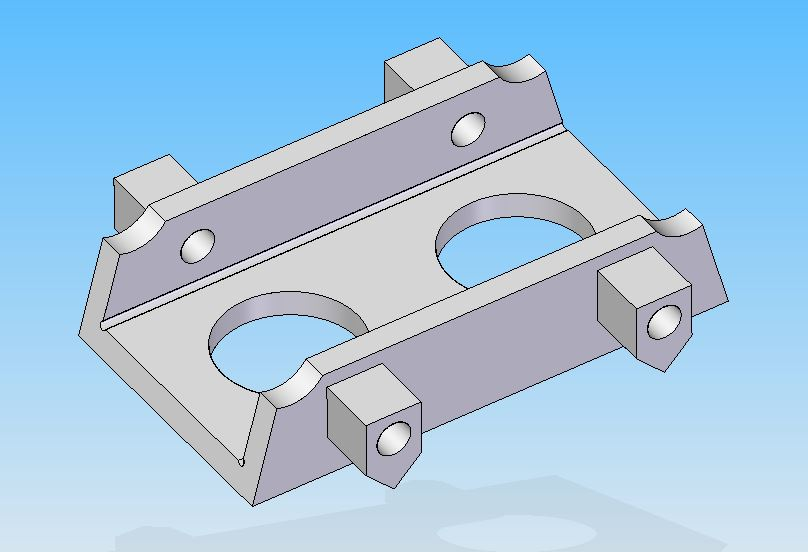
[picture p98: docs/source/Machine/figures/Jig_Drill_Small_Frame-Pic-Machine-DIY-LM42P.JPG]
  

STL file -> |JigDrillSmallFrameSTL|

.. |JigDrillSmallFrameSTL| raw:: html

  <a href="https://www.thingiverse.com/thing:4723209/files"
  target="_blank">Jig Drill Small Frame STL</a>	       

Bushing
^^^^^^^

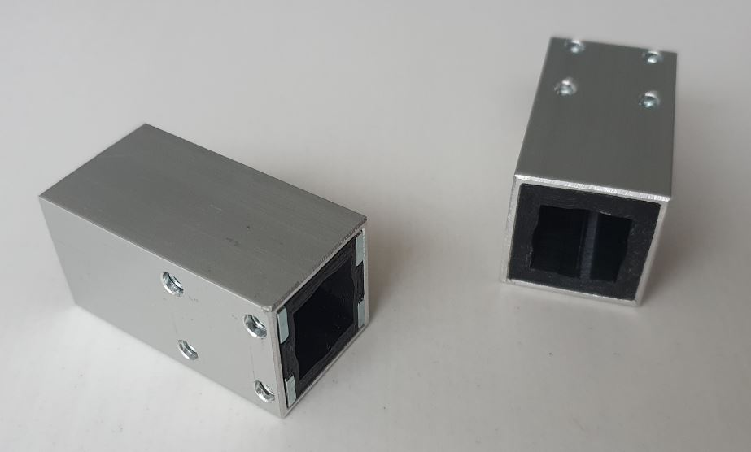
[picture p99: docs/source/Machine/figures/Bushing-Pic-Machine-DIY-LM42P.JPG]


Video
'''''

This video shows how to make the Bushing.

.. raw:: html

    <iframe width="350" height="245"
    src="https://www.youtube.com/embed/c_V-n5I3b1s"
    frameborder="0" 
    allowfullscreen></iframe>

Quantity : 2x

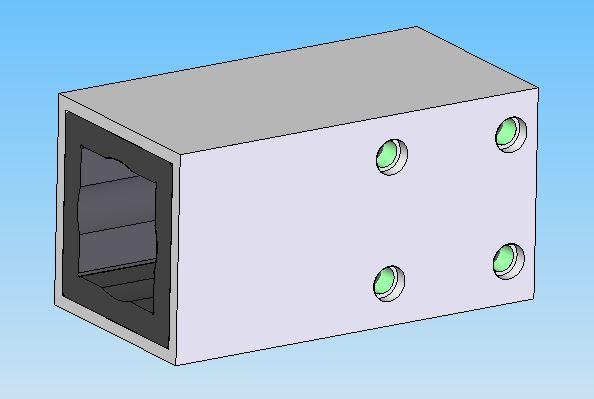
[picture p100: docs/source/Machine/figures/Bushing-Machine-DIY-LM42P.JPG]

	    
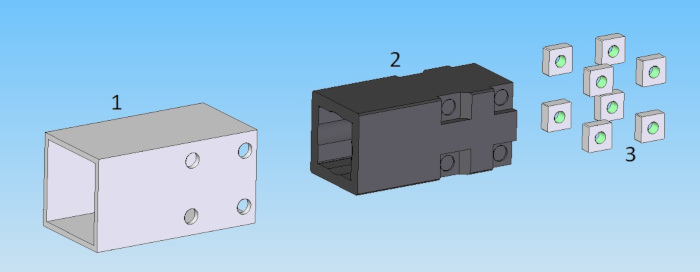
[picture p101: docs/source/Machine/figures/Bushing-Exploded-Machine-DIY-LM42P.JPG]


Bushing Sleeve
''''''''''''''

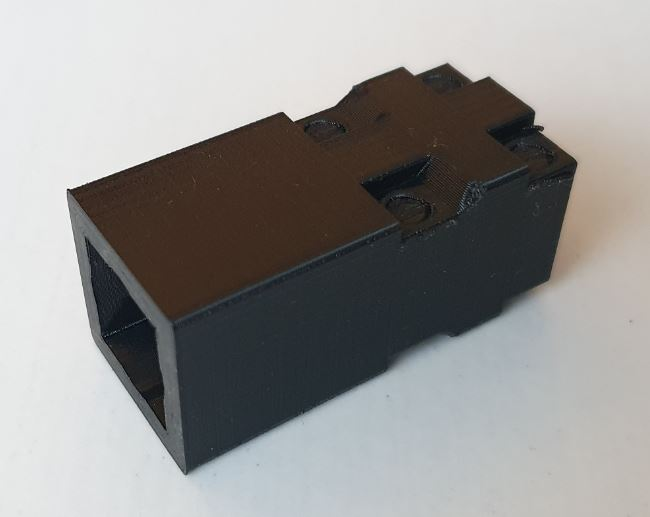
[picture p102: docs/source/Machine/figures/Bushing_Sleeve-Machine-DIY-LM42P.JPG]


- Material : nylon
- STL file -> |BushingSleeveSTL|

.. |BushingSleeveSTL| raw:: html

    <a href="https://www.thingiverse.com/thing:4720838/files"
    target="_blank">Bushing Sleeve STL</a>

Bushing Shell
'''''''''''''

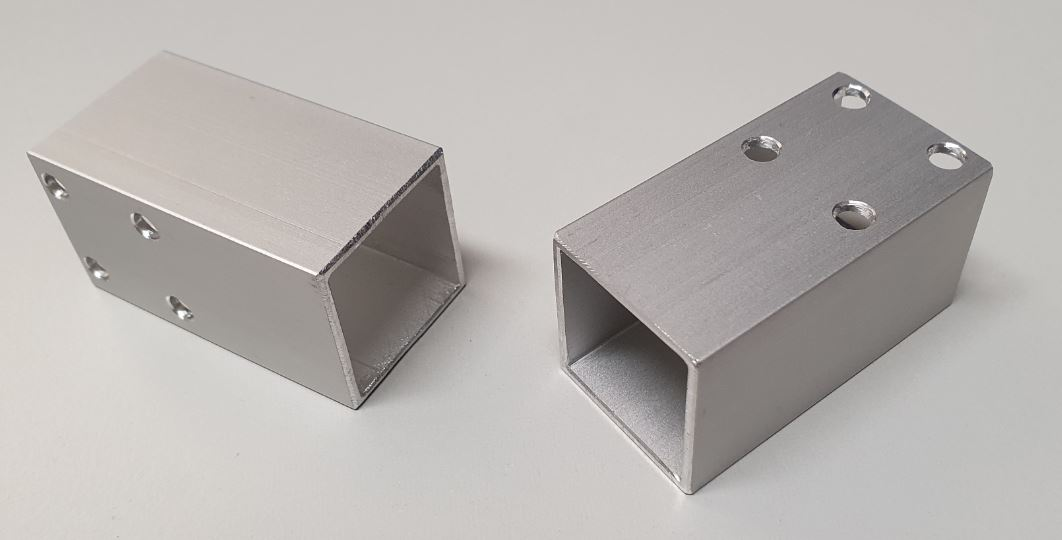
[picture p103: docs/source/Machine/figures/Bushing_Shell-Pic-Machine-DIY-LM42P.JPG]

	    
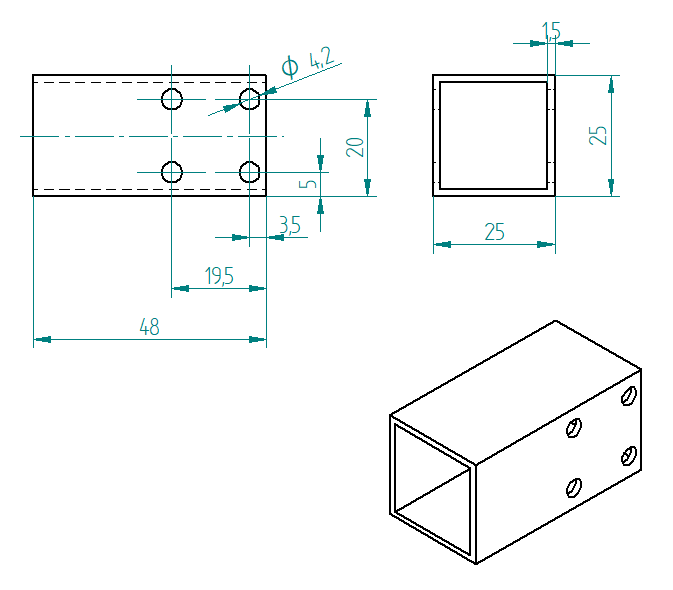
[picture p104: docs/source/Machine/figures/Bushing_Shell-Drawing-Machine-DIY-LM42P.PNG]


**Jig Drill Bushing Shell**

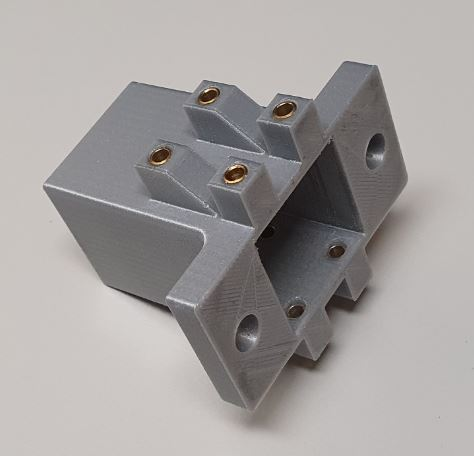
[picture p105: docs/source/Machine/figures/Jig_Drill_Bushing_Shell-Pic-Machine-DIY-LM42P.JPG]
  

STL file -> |JigDrillBushingShellSTL|

.. |JigDrillBushingShellSTL| raw:: html

  <a href="https://www.thingiverse.com/thing:4723355/files"
  target="_blank">Jig Drill Bushing Shell STL</a>	       

Spacer
^^^^^^

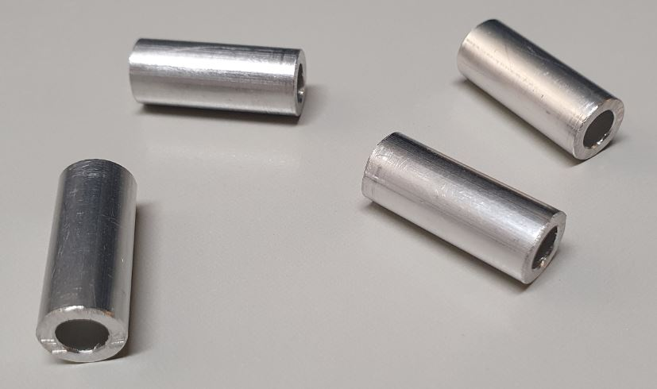
[picture p106: docs/source/Machine/figures/Spacer-Pic-Machine-DIY-LM42P.JPG]


This video shows how to make the Spacer.

.. raw:: html

    <iframe width="350" height="245"
    src="https://www.youtube.com/embed/c_V-n5I3b1s?start=267&end=314"
    frameborder="0" 
    allowfullscreen></iframe>	    

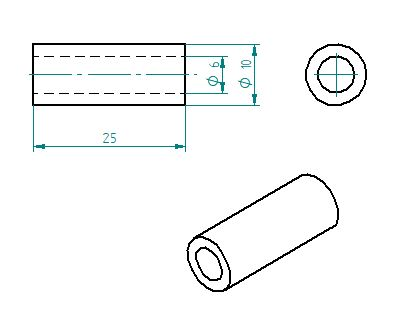
[picture p107: docs/source/Machine/figures/Spacer-Drawing-Machine-DIY-LM42P.JPG]


Moving Parts
------------

Listing Parts
^^^^^^^^^^^^^
Motor
'''''
Quantity : 1x

Timing Pulley
'''''''''''''
- Quantity : 1x
- Type : HTD3M Type 40T
- Size : hole diameter = 8mm width =  16mm

  .. |TimingPulleyAliexpress| raw:: html

    <a href="https://www.aliexpress.com/item/32816074465.html?spm=a2g0s.9042311.0.0.27424c4dc8WrRN"
    target="_blank">Aliexpress</a>
  
- Where to buy : |TimingPulleyAliexpress|

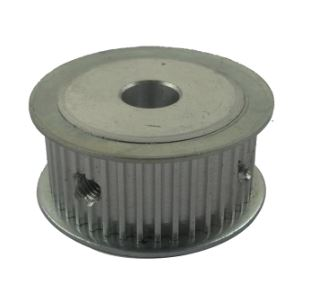
[picture p108: docs/source/Machine/figures/Timing_Pulley-Machine-DIY-Machine.JPG]


Timing Belt
'''''''''''
Quantity : 1x

Idler Pulley Long Screw
'''''''''''''''''''''''
Quantity : 2x

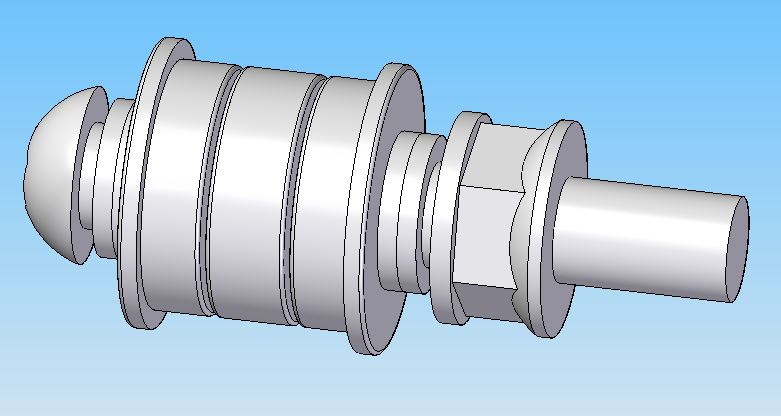
[picture p109: docs/source/Machine/figures/Idler_Pulley_Long_Screw-Machine-DIY-LM42P.JPG]


Idler Pulley Short Screw
''''''''''''''''''''''''
Quantity : 2x

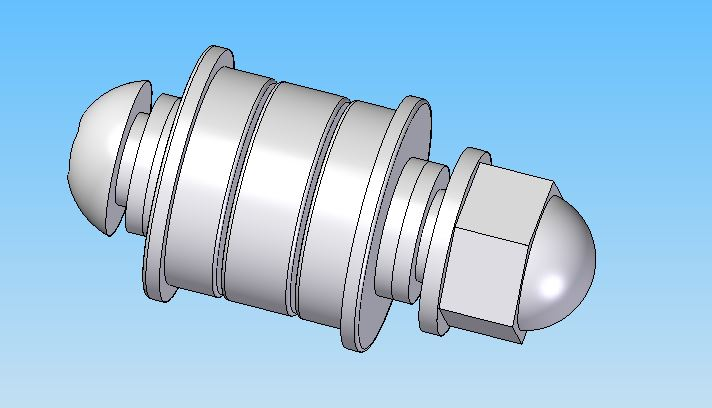
[picture p110: docs/source/Machine/figures/Idler_Pulley_Short_Screw-Machine-DIY-LM42P.JPG]


Belt Joint
''''''''''
Quantity : 1x

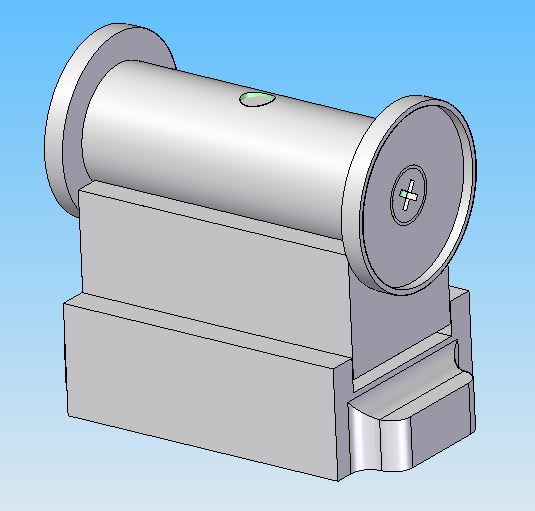
[picture p111: docs/source/Machine/figures/Belt_Joint-Machine-DIY-LM42P.JPG]


Rod
'''
Quantity : 1x or 2x

Idler Pulley Long Screw
^^^^^^^^^^^^^^^^^^^^^^^

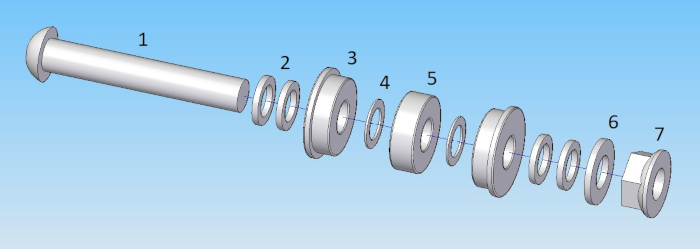
[picture p112: docs/source/Machine/figures/Idler_Pulley_Long_Screw_Exploded-Machine-DIY-LM42P.JPG]


Listing Parts
'''''''''''''

1) Long Screw M8
  
  - Quantity : 1x
  - Length : 50mm  
  - Material : stainless
        
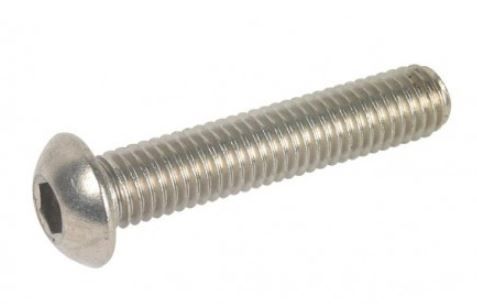
[picture p113: docs/source/Machine/figures/Long_Screw-Machine-DIY-LM42P.JPG]
  
	    
2) Washer 8 x 12 x 1.5

  - Quantity : 4x
  - Material : aluminium
    
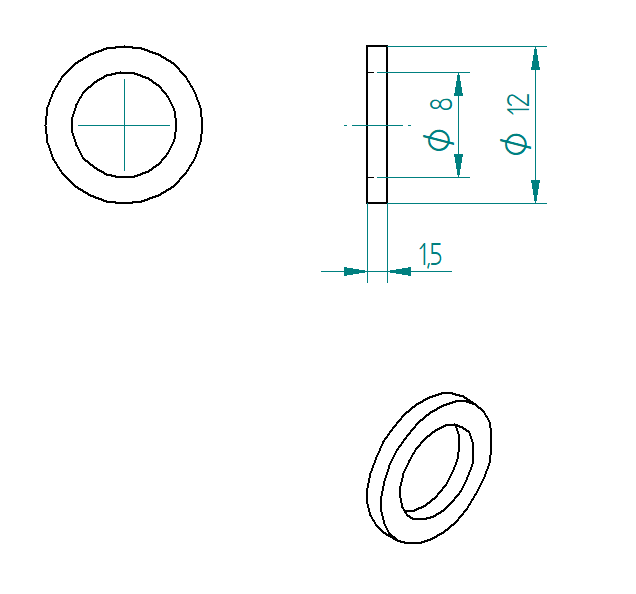
[picture p114: docs/source/Machine/figures/Washer_8x12x1_5-Machine-DIY-LM42P.PNG]
  

.. note::
   
   Maybe better to use 1x Stainless steel Flat Washer Thickness 1mm 
   (8x14x1mm) and 1x Stainless steel Flat Washer 0.5mm
   (8x14x0.5). 1.5mm doesn't exist. Because aluminum tends to crush
   when it's squeezed.
   
3) Flange Ball Bearing

  - Quantity : 2x
  - Type : F698ZZ
  - Size : 8 x 19 x 6 mm
    
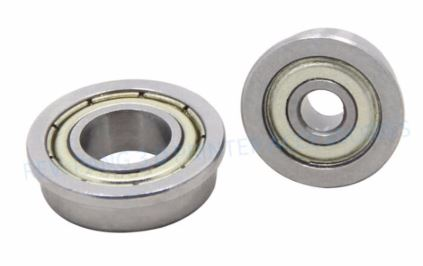
[picture p115: docs/source/Machine/figures/Flange_Ball_Bearing-Machine-DIY-LM42P.JPG]
  

4) Flat Washer

  - Quantity : 2x
  - Thickness : 0.5mm
  - Size : 8 x 12 x 0.5 mm
  - Material : stainless  
    
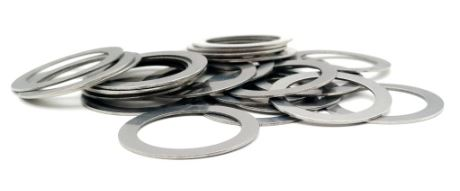
[picture p116: docs/source/Machine/figures/Flat_Washer-Machine-DIY-LM42P.JPG]
  
   
5) Bearing

   - Quantity : 1x
   - Type : 698ZZ
   - Size : 8 x 19 x 6 mm  

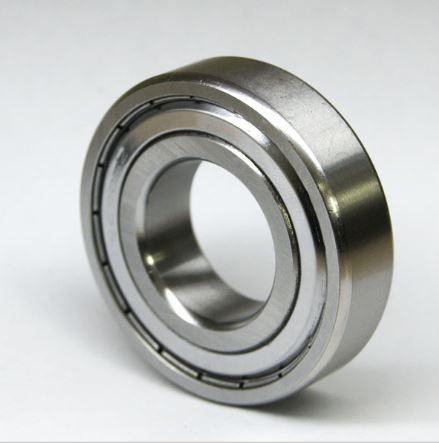
[picture p117: docs/source/Machine/figures/Bearing-Machine-DIY-LM42P.JPG]
  

6) Washer M6

   - Quantity : 1x
   - Material : stainless  
   - Size : 8 x 16 x 1.6 mm  

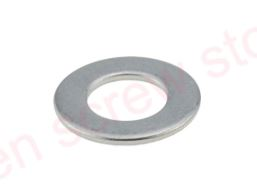
[picture p118: docs/source/Machine/figures/Washer_M8-Machine-DIY-LM42P.JPG]
  
	    
7) Nuts M8 Stop

  - Quantity : 1x
  - Material : stainless

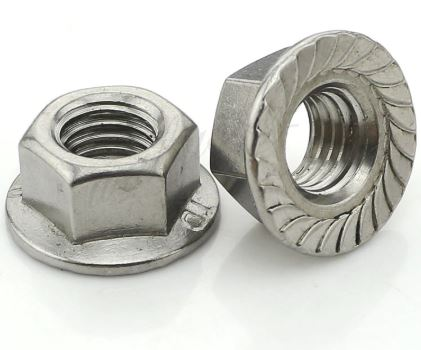
[picture p119: docs/source/Machine/figures/Nuts_M8_Stop-Machine-DIY-LM42P.JPG]
  

Idler Pulley Short Screw
^^^^^^^^^^^^^^^^^^^^^^^^

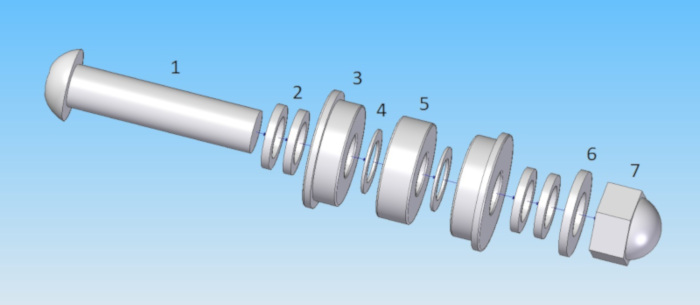
[picture p120: docs/source/Machine/figures/Idler_Pulley_Short_Screw_Exploded-Machine-DIY-LM42P.JPG]
  

Listing Parts
'''''''''''''

1) Short Screw M8
  
  - Quantity : 1x
  - Length : 35mm
  - Material : stainless

  
    
2) Washer 8 x 12 x 1.5

  - Quantity : 4x
  - Material : aluminium
    
  

.. note::
   
   Maybe better to use 1x Stainless steel Flat Washer Thickness 1mm 
   (8x14x1mm) and 1x Stainless steel Flat Washer 0.5mm
   (8x14x0.5). Because aluminum tends to crush when it's squeezed. 

3) Flange Ball Bearing

  - Quantity : 2x
  - Type : F698ZZ
  - Size : 8 x 19 x 6 mm
    
  

4) Flat Washer

  - Quantity : 2x
  - Thickness : 0.5mm
  - Size : 8 x 12 x 0.5 mm
  - Material : stainless  
    
  
   
5) Bearing

   - Quantity : 1x
   - Type : 698ZZ
   - Size : 8 x 19 x 6 mm  

  

6) Washer M8

   - Quantity : 1x
   - Material : stainless  
   - Size : 8 x 16 x 1.6 mm  

  

7) Cap Nuts M8

   - Quantity : 1x
   - Material : stainless  

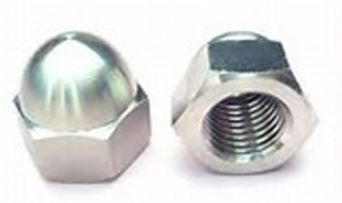
[picture p121: docs/source/Machine/figures/Cap_Nuts_M8-Machine-DIY_LM42P.JPG]
  

Belt Joint
^^^^^^^^^^

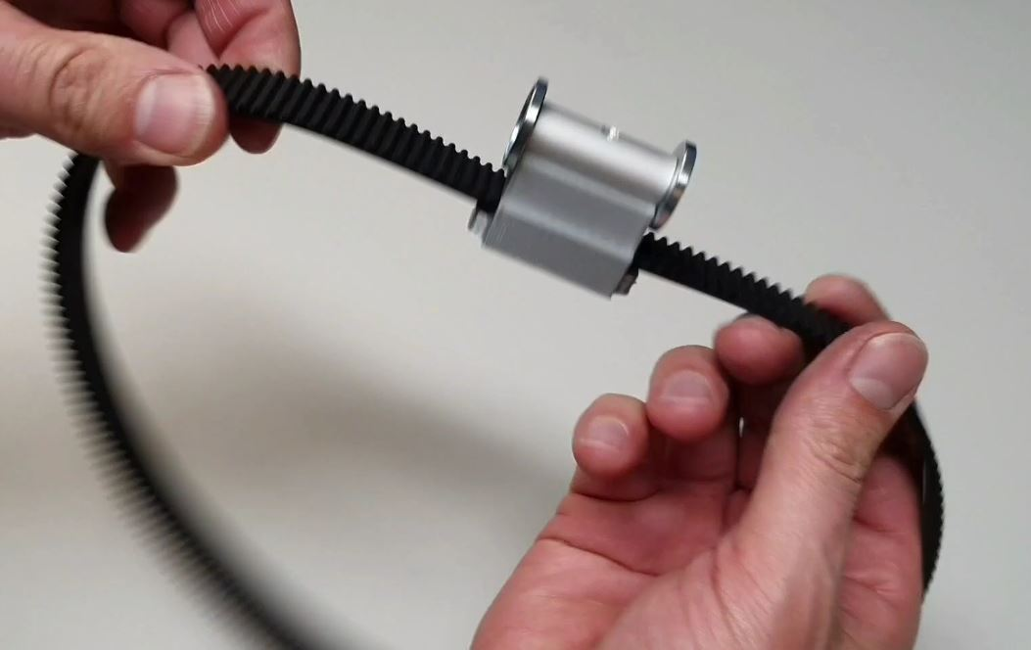
[picture p122: docs/source/Machine/figures/Belt_Joint_Pic-Machine-DIY-LM42P.JPG]


Video
'''''

This video shows how to make the Belt Joint

.. raw:: html

    <iframe width="350" height="245"
    src="https://www.youtube.com/embed/40f_kVVAy8c"
    frameborder="0" 
    allowfullscreen></iframe>

Listing Parts
'''''''''''''

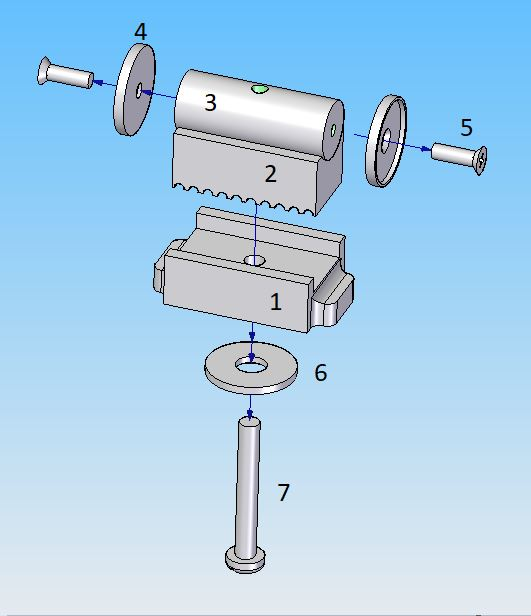
[picture p123: docs/source/Machine/figures/Belt_Joint_Exploded-Machine-DIY-LM42P.JPG]


1. Base Belt Joint
   
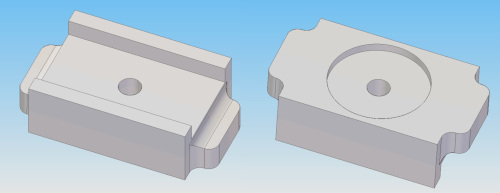
[picture p124: docs/source/Machine/figures/Base_Belt_Joint-Machine-DIY-LM42P.JPG]
   
	    
  - Quantity : 1x
  - Material : 3D printed PLA (innerfill = 100%)
  - STL file -> |BaseBeltJointSTL|

  .. |BaseBeltJointSTL| raw:: html

    <a href="https://www.thingiverse.com/thing:4718335/files"
    target="_blank">Base Belt Joint STL</a>

2. Counterpart Base Belt Joint 

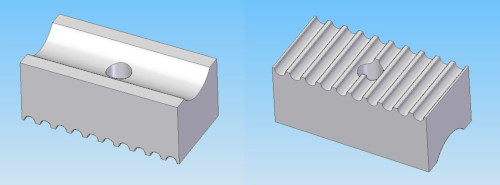
[picture p125: docs/source/Machine/figures/Counterpart_Base_Belt_Joint-Machine-DIY-LM42P.JPG]
   
   
  - Quantity : 1x
  - Material : 3D printed PLA (innerfill = 100%)
  - STL file -> |ConterPartBaseBeltJointSTL|

  .. |ConterPartBaseBeltJointSTL| raw:: html

    <a href="https://www.thingiverse.com/thing:4714825/files"
    target="_blank">Counterpart Base Belt Joint STL</a>

3. Spacer Metal Disc

  - Quantity : 1x
  - Material : Aluminium

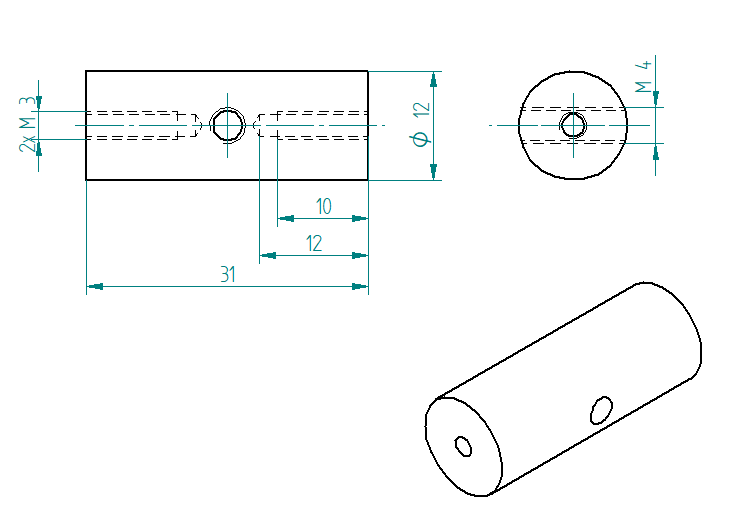
[picture p126: docs/source/Machine/figures/Spacer_Metal_Disc.PNG]

	    
4. Metal Disc

  - Quantity : 2x
  - Type : MSD-17
  - Inner diameter 17 mm, as a counterpart to magnets, not a magnet!  

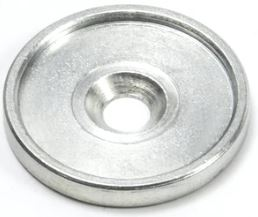
[picture p127: docs/source/Machine/figures/Metal_Disc-Machine-DIY-LM42P.JPG]


5. Phillips Head Screw M3 x 10

  - Quantity : 2x
  - Material : steel (should be magnetic)

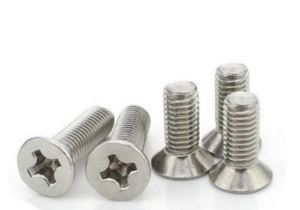
[picture p128: docs/source/Machine/figures/Phillips_Head_Screw_M3x10.JPG]


6. Washer M6 x 6.4 x 18 x 1.6

  - Quantity : 1x
  - Material : steel

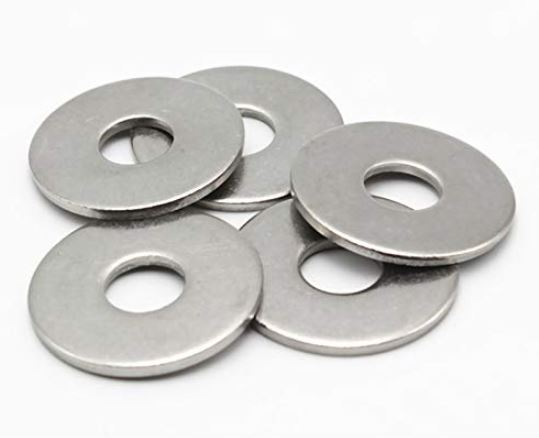
[picture p129: docs/source/Machine/figures/Washer_M6x6_4x18x1_6-Machine-DIY-LM42P.JPG]

       
7. Screw Pan Head Slot M4 x 40

  - Quantity : 1x
  - Material : steel

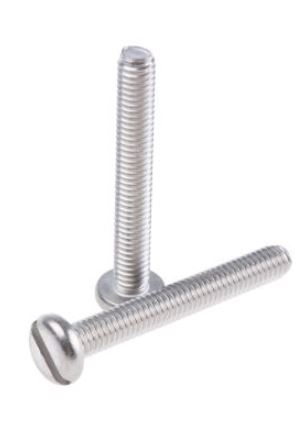
[picture p130: docs/source/Machine/figures/Screw_Pan_Head_Slot_M4x40-Machine-DIY-LM42P.JPG]


Rod
^^^

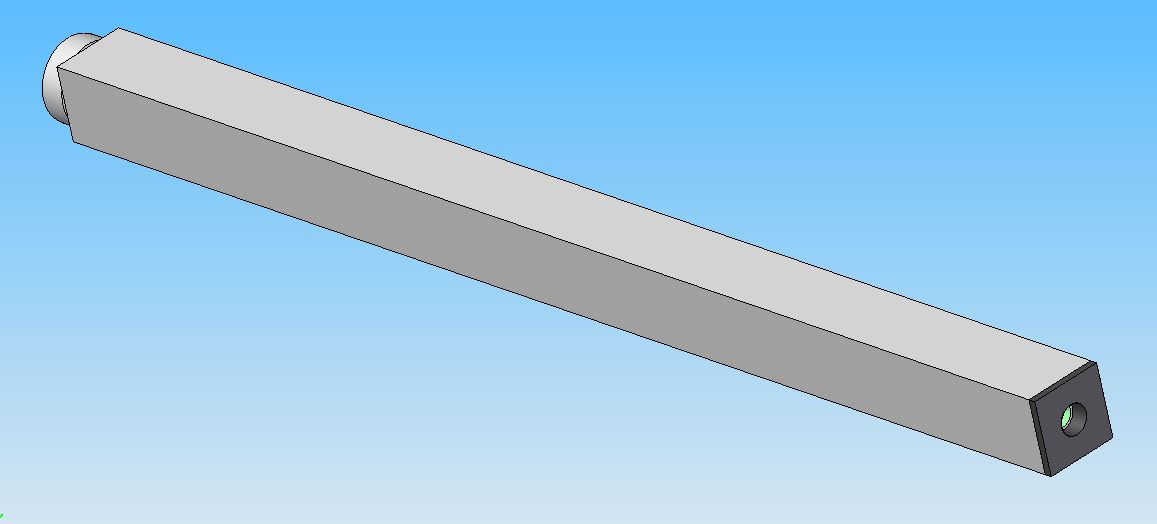
[picture p131: docs/source/Machine/figures/Rod-DIY-LM42P.JPG]


Video
'''''

This video shows how to make the Rod

.. raw:: html

    <iframe width="350" height="245"
    src="https://www.youtube.com/embed/hlsWKp7FWDQ"
    frameborder="0" 
    allowfullscreen></iframe>

Listing Parts
'''''''''''''

#. Scare Tube 15 x 15 x 249
   
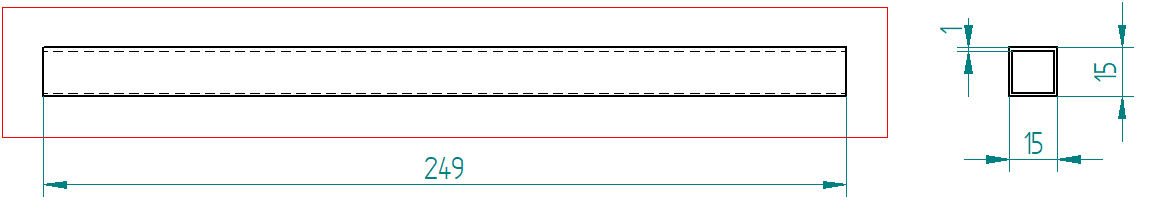
[picture p132: docs/source/Machine/figures/Square_Tube_15_15_249-Machine-DIY-LM42P.PNG]
   
	    
#. Insert M4 x 12
#. Magnet

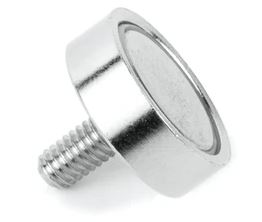
[picture p133: docs/source/Machine/figures/Magnet-Rod-DIY-LM42P.JPG]
   

   Pot magnet with threaded stud diam. 16mm Thread M4 strength
   approx. 8kg

   - Quantity : 1x
   - Type : GTN-16

   .. |PotMagnetSupermagnete| raw:: html

     <a href="https://www.supermagnete.ch/eng/pot-magnets-with-threaded-stud/pot-magnet-with-threaded-stud-16mm_GTN-16"
     target="_blank">supermagnete.ch</a>
  
   - Where to buy : |PotMagnetSupermagnete|

   .. note::
      It's important to buy at supermagnete because I bought some in
      Aliexpress but the strength is lower than those bought at supermagnete

#. Spacer 25 / M6

Manufacturing Process
'''''''''''''''''''''

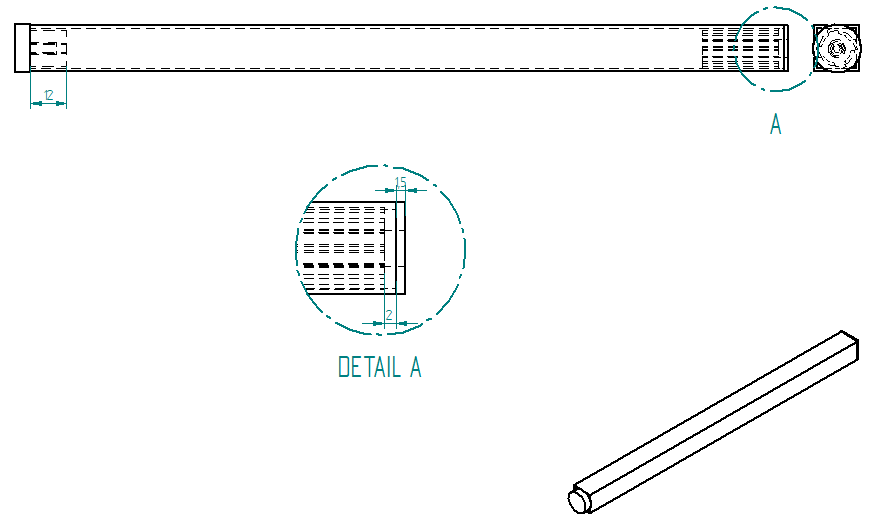
[picture p134: docs/source/Machine/figures/Rod_Assembly-Machine-DIY-LM42P.PNG]


#. Cut the Square Tube 15 x 15 x 249 at length = 249mm
#. Make the the Insert M4 x 12

Assembly
--------

Video
^^^^^

.. raw:: html

    <iframe width="350" height="245"
    src="https://www.youtube.com/embed/k691ffIHoc0?start=0&end=1542"
    frameborder="0" 
    allowfullscreen></iframe>

There is an error occured in this video the bolts (in red) should be
mounted like on these images : 

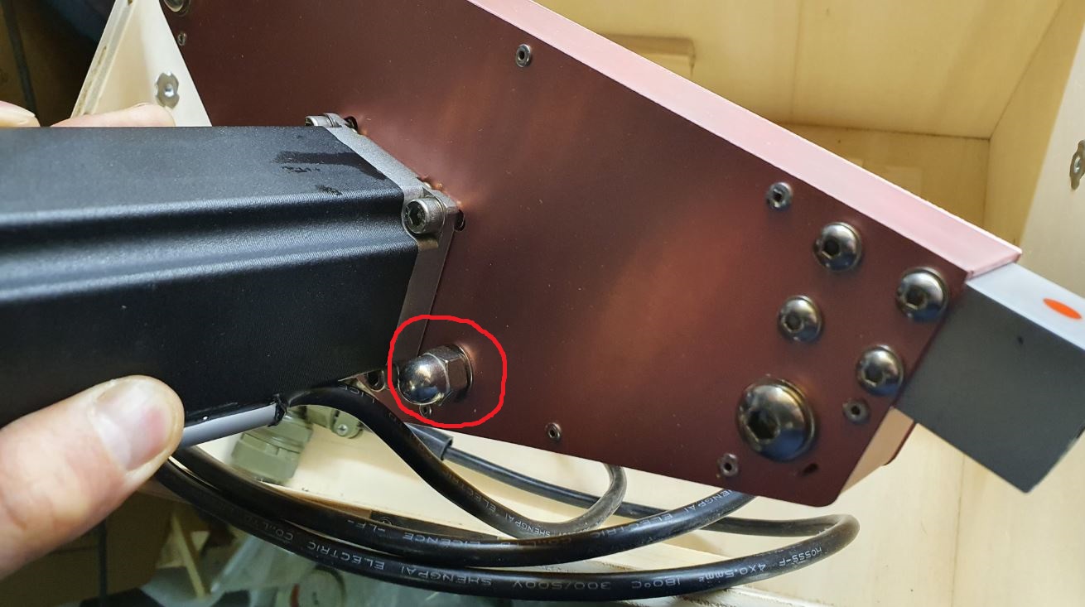
[picture p135: docs/source/Machine/figures/HowTheAssemblyShouldBe1.JPG]


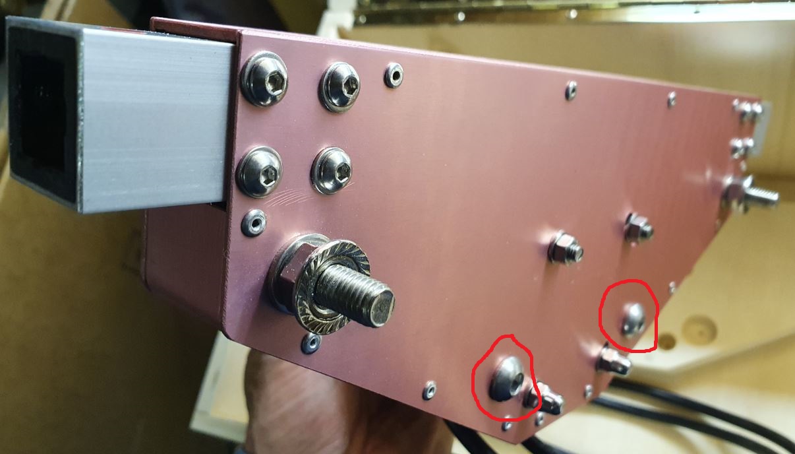
[picture p136: docs/source/Machine/figures/HowTheAssemblyShouldBe2.JPG]


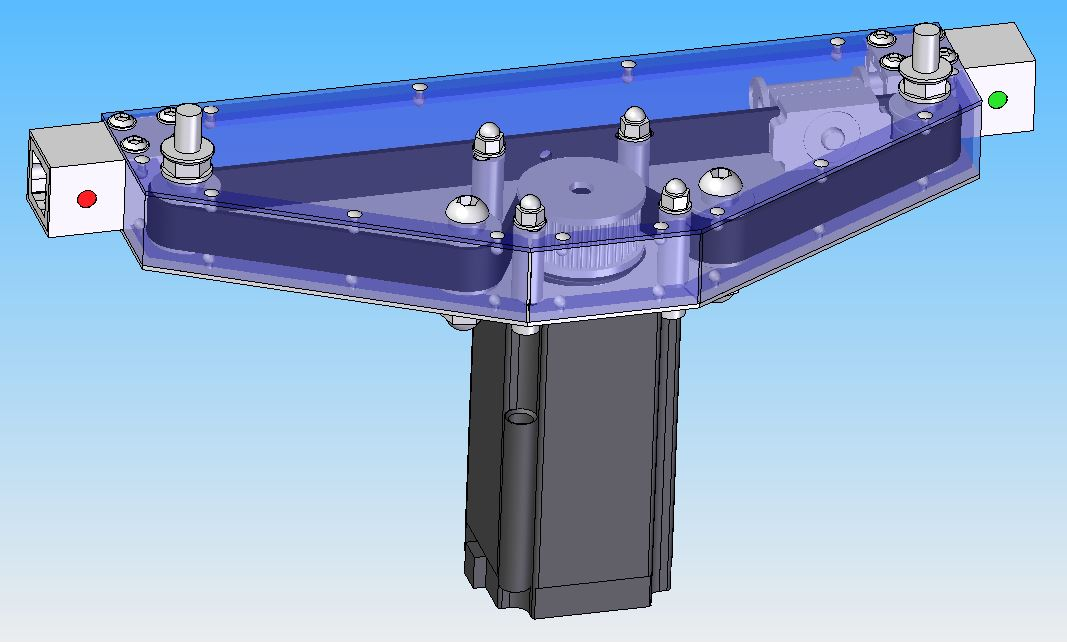
[picture p137: docs/source/Machine/figures/Machine-DIY-LM42P.JPG]


Listing Parts
'''''''''''''
- Rivets

  - Quantity : 28
  - Supplier : Debrunner
  
  
	    
