lm42p/diy/docs/source/FasteningElements/FasteningElements.rst

Fastening Elements
==================

Video
-----

.. raw:: html

    <iframe width="350" height="245"
    src="https://www.youtube.com/embed/WM_JbWVXLaU?start=0&end=1841"
    frameborder="0" 
    allowfullscreen></iframe>

Mast
----

Tools
^^^^^

Building Plate
--------------

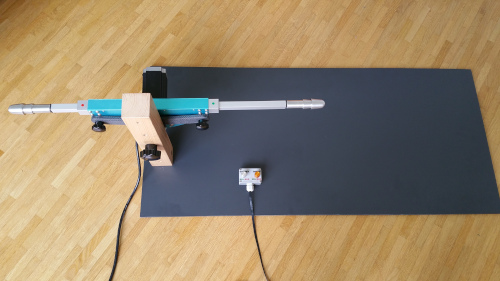
[picture p138: docs/source/FasteningElements/figures/Building-Plate.jpg]


- Material : RESOPAL
- Thinkness : 6mm
- Size : 450 x 950 x 6 mm
- Weight : 4kg 
	  
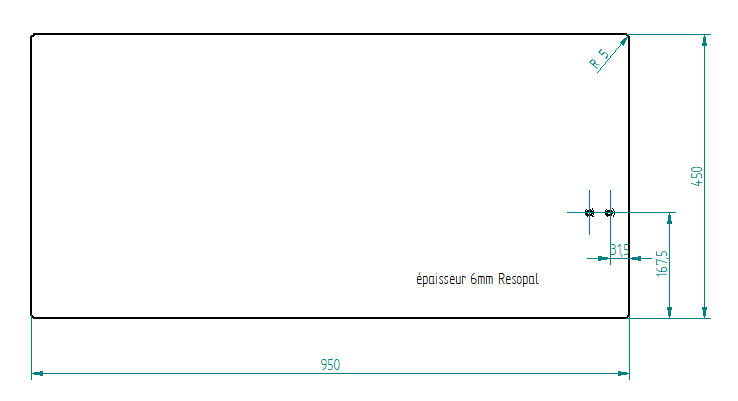
[picture p139: docs/source/FasteningElements/figures/Building-Plate.PNG]


Fastening bolt
--------------

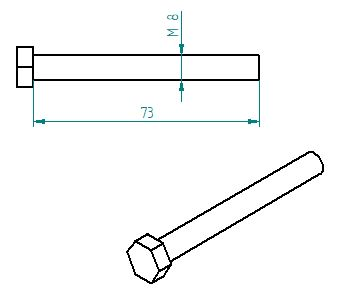
[picture p140: docs/source/FasteningElements/figures/Fastening-Bolt.png]


1. Saw the bolt

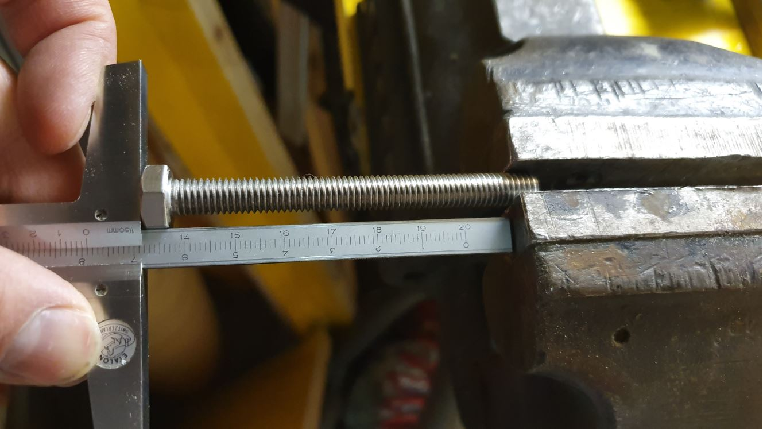
[picture p141: docs/source/FasteningElements/figures/Cut-Fastening-Bolt.jpg]


2. Deburr the bolt

Silicon-Protection 60x40x3
---------------------------

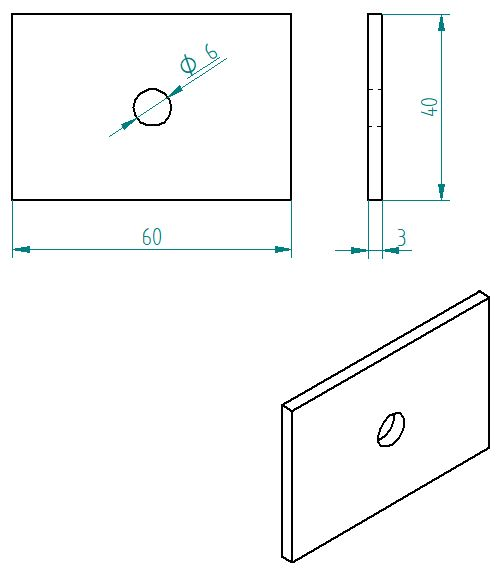
[picture p142: docs/source/FasteningElements/figures/Silicone-Plate-60x40x3.png]


1. Cut the plate with a cutter
2. Cut wiht a cookie cutter  the hole diameter 6mm

Silicon-Protection 80x100x8
---------------------------

From a silicon plate 200x200x8 cut 4x parts 80x100 see following figure.

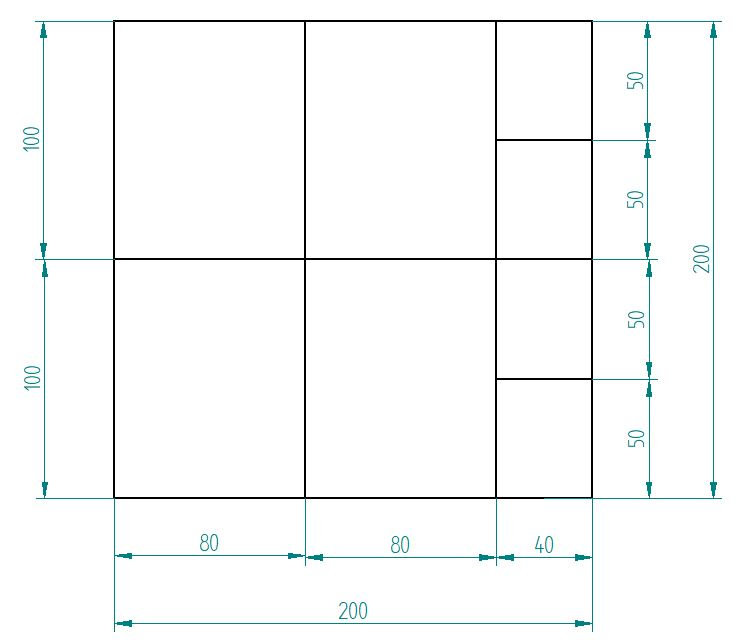
[picture p143: docs/source/FasteningElements/figures/SiliconProtection.JPG]


Silicon-Protection 40x50x8
---------------------------

From a silicon plate 200x200x8 cut 4x parts 40x50 mm see preceding figure.

Allen Cone Head Screw
---------------------

- Type : M8 x 45mm
- Supplier : Debrunner
- N° Article : 101 14 091

Allen Tightening Key
--------------------

- Type : 5mm
- Supplier : Debrunner
- N° Article : 811 305 240
