lm42p/diy/docs/source/StorageBox/StorageBox.rst

Storage Box
===========

Video
-----

See the video that shows how to make the Storage Box step by step.  

.. raw:: html

    <iframe width="350" height="245"
    src="https://youtube.com/embed/92ZsRvFD_6w"
    frameborder="0" 
    allowfullscreen></iframe>

Listing Parts
-------------

- Wooden Screw 2.5/9

  - quantity = 6x
  - diameter = 2.5mm
  - length = 9mm
  - head diameter = 5mm
  
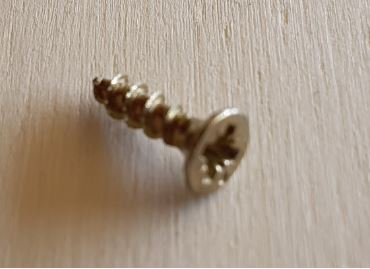
[picture p144: docs/source/StorageBox/figures/Wooden_Screw_2.5_9-DIY-Storage-Box-LM42P.JPG]
    

- Wooden Screw 2/17

  - quantity = 6x
  - diameter = 2.5mm
  - length = 17mm
  - head diameter = 4mm

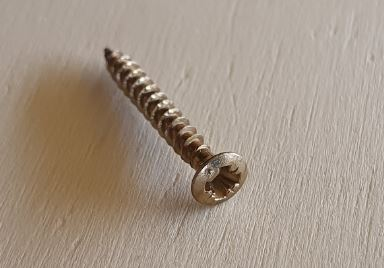
[picture p145: docs/source/StorageBox/figures/Wooden_Screw_2_17-DIY-Storage-Box-LM42P.JPG]
    

- Wooden Screw Hole M4

  - quantity = 4x
  - diameter = M4

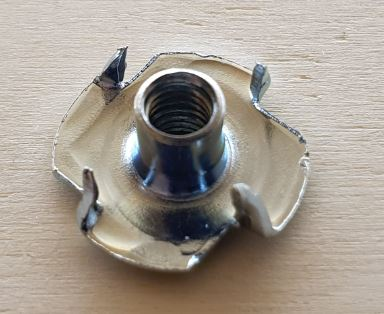
[picture p146: docs/source/StorageBox/figures/Wooden_Screw_Hole_M4-Storage-Box-DIY-LM42P.JPG]
    

- Screw M4

    - quantity = 4x
    - diameter = M4
    - length = 10mm

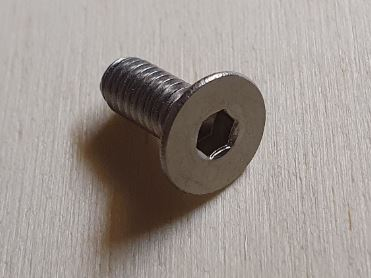
[picture p147: docs/source/StorageBox/figures/Screw_M4-Storage-Box-DIY-LM42P.JPG]
    

- Hinge

    - quantity = 1x

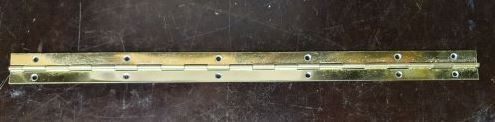
[picture p148: docs/source/StorageBox/figures/Hinge-DIY-LM42P.JPG]
      

- Handle

    - quantity = 2x
    - material = stainless

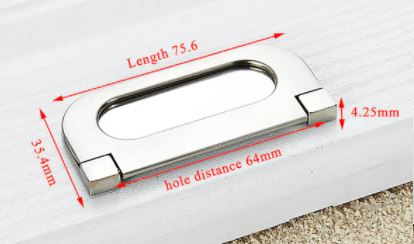
[picture p149: docs/source/StorageBox/figures/Handle-DIY-LM42P.JPG]
      

- Womdee 3mm

    - quantity = a lot
    - material = wood

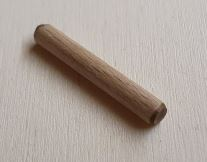
[picture p150: docs/source/StorageBox/figures/Womdee_dia_3_length_22-Storage-Box-DIY-LM42P.JPG]
    
  
- Double-sided Tape

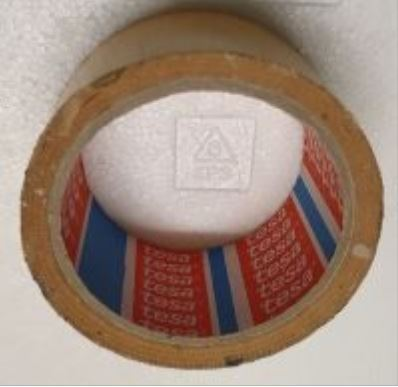
[picture p151: docs/source/StorageBox/figures/Double_Sided_Tape-DIY-LM42P.JPG]
        
		
- Wood Glue

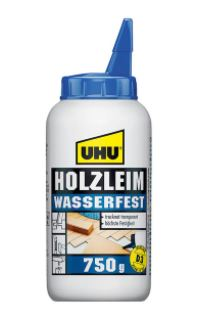
[picture p152: docs/source/StorageBox/figures/Wood_Glue-DIY-LM42P.JPG]
