lm42p/diy/docs/source/index.rst

.. lm42p-diy documentation master file, created by
   sphinx-quickstart on Thu Oct 31 19:51:53 2019.
   You can adapt this file completely to your liking, but it should at least
   contain the root `toctree` directive.

Welcome to lm42p-diy's documentation!
=====================================

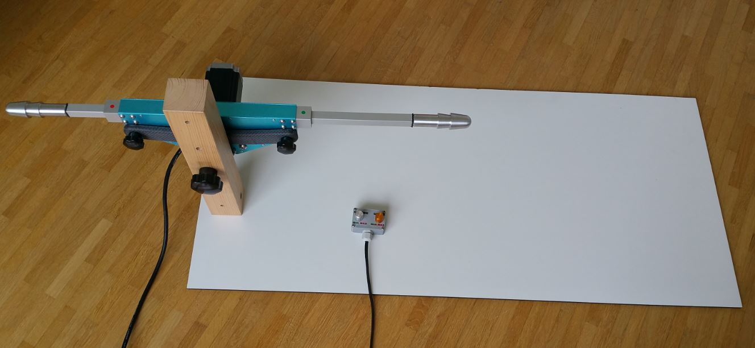
[picture p153: docs/source/Title-Picture-LM42P.jpg]

		
On this page you will find all the information you need to build the
LoveMachine42People. Five parts are dedicated to detail all the
operations of realization. You will find respectively the plans for
the Machine, the Electrical Part, the Fixing Components, the
Accessories and the Wooden Storage Box. 

This page is under construction, so it may not contain all the details
yet. But come back from time to time to see the progress. 

This page takes me a lot of time to write, it would be a great support
if you could make a small donation for its realization by clicking on
the PayPal logo below or by subscribing to my youtube channel.  That
way, I will be all the more motivated to finish it quickly and it will
allow me to know your interest in acquiring the plans of this
machine. 

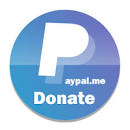
[picture p154: docs/source/LogoPayPalMe.jpg]
  





Thank You a thousand times for your support!

The puplication of this document is only dedicated to the manufacture
of your personal machine. You can read it for educational
purposes. Any use of this document for commercial purposes is strictly 
prohibited. The copy of all parts referring to this product (photos,
videos, plans) is prohibited and must be requested to the author
LM42P. 

.. toctree::
   :maxdepth: 2
   :caption: Contents:

   Machine/Machine	     
   ElectricalPart/ElectricalPart
   Code/Code
   Accessories/Accessories
   FasteningElements/FasteningElements
   StorageBox/StorageBox
   Donate
   Contact

Indices and tables
==================

* :ref:`genindex`
* :ref:`modindex`
* :ref:`search`
