lm42p/diy/docs/source/Donate.rst

Donate
======

Please give me a small tip to help me continue this self-buiding
site! Click the following Paypal.me Icon or subscribe to my Youtube
Channel.

  





Thank You very much!
