lm42p/diy/docs/source/ElectricalPart/figures/Entretoise8_6-LM42P.PNG

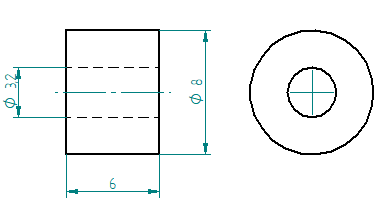
docs/source/ElectricalPart/figures/Entretoise8_6-LM42P.PNG
