lm42p/diy/docs/source/ElectricalPart/figures/LM42P-SchematicGeckoESP32Encoder.png

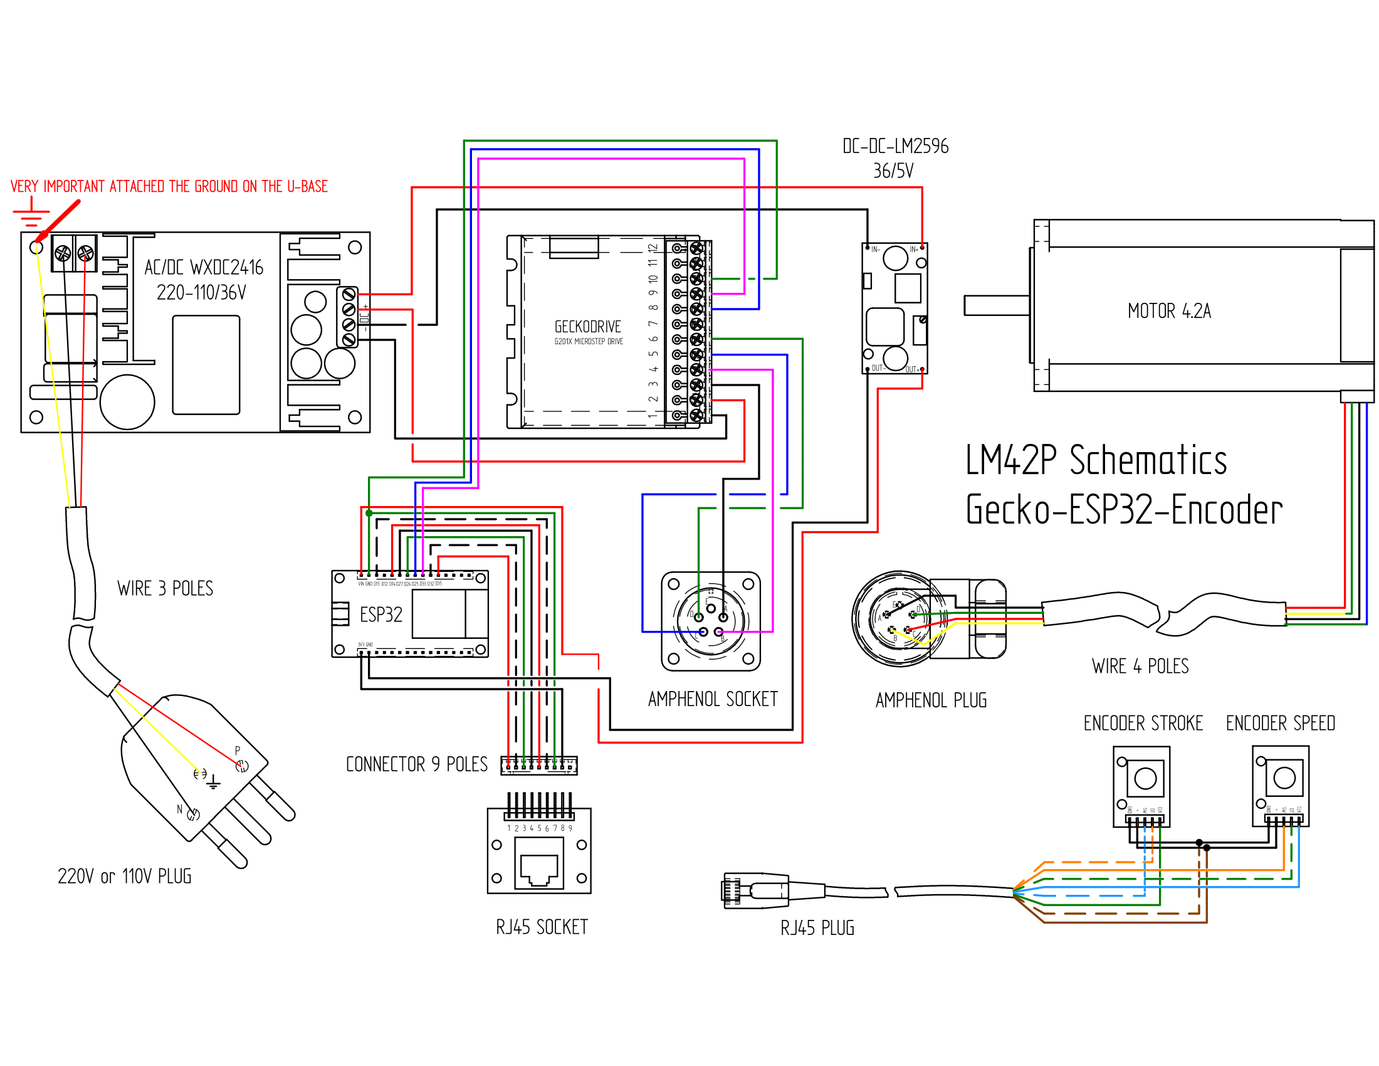
docs/source/ElectricalPart/figures/LM42P-SchematicGeckoESP32Encoder.png
