lm42p/diy/docs/source/ElectricalPart/figures/Reglage-Sciage-Vis-M8-Fixation.PNG

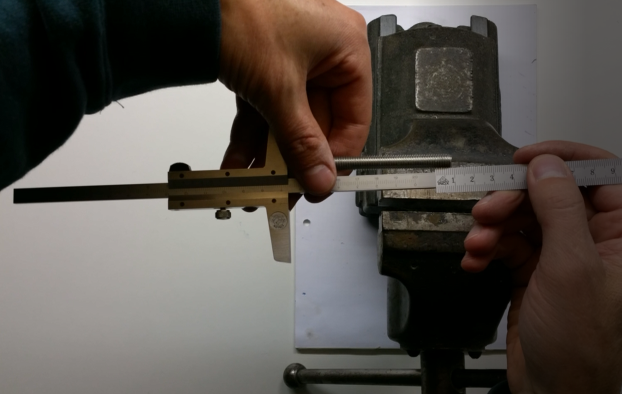
docs/source/ElectricalPart/figures/Reglage-Sciage-Vis-M8-Fixation.PNG
