lm42p/diy/docs/source/ElectricalPart/figures/Schema-Cablage-Tableau.jpg

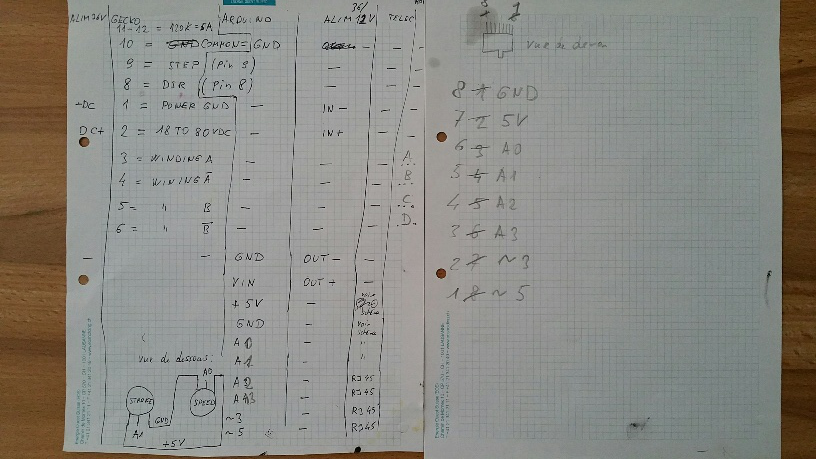
docs/source/ElectricalPart/figures/Schema-Cablage-Tableau.jpg
