lm42p/diy/docs/source/Machine/figures/Casing-Machine-DIY-LM42P.JPG

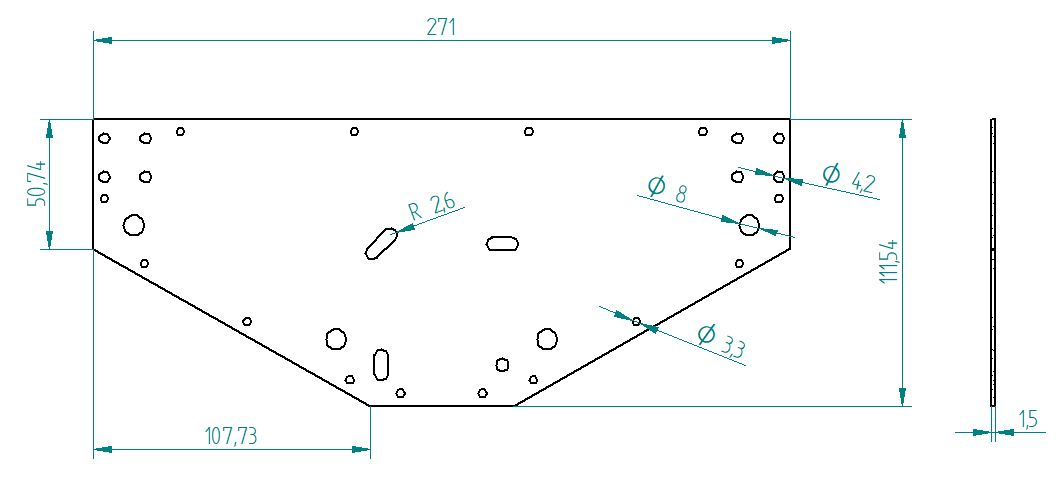
docs/source/Machine/figures/Casing-Machine-DIY-LM42P.JPG
