lm42p/diy/docs/source/Machine/figures/ReglageImpr3DTaquet.PNG

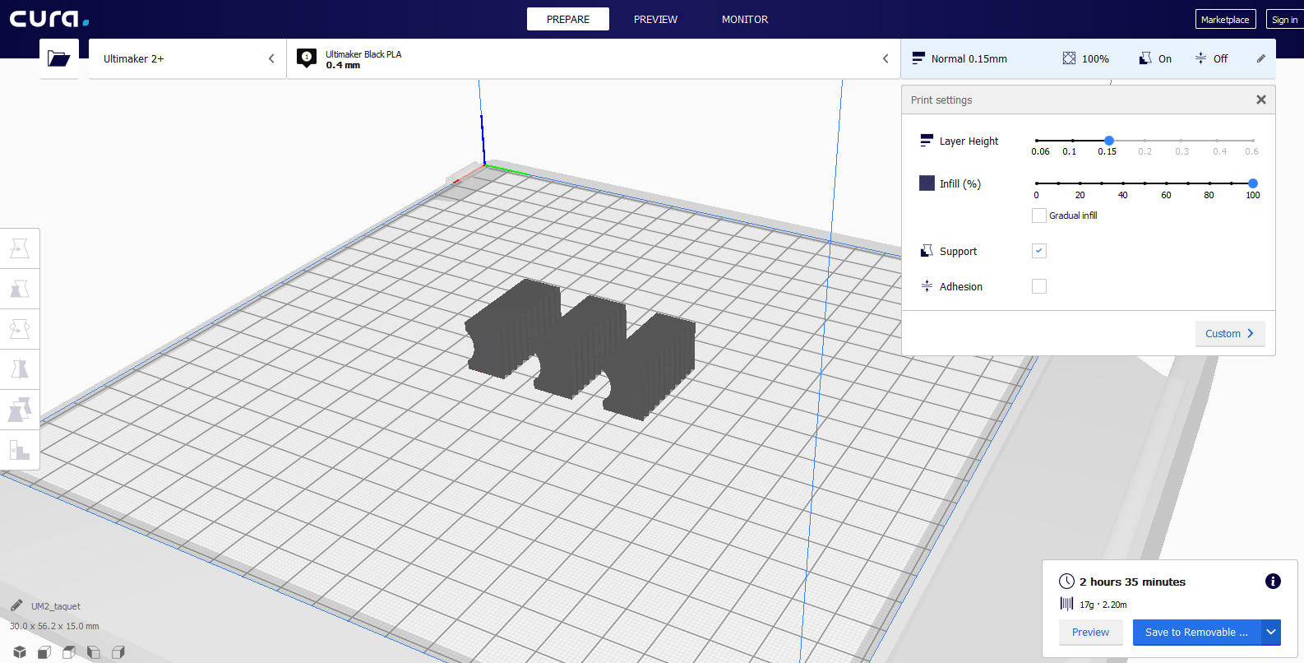
docs/source/Machine/figures/ReglageImpr3DTaquet.PNG
