lm42p/diy/(commit log)

2021-12-31 ajout de Suction Cup Dildo Adapter sous Accessories
2023-04-21 schematic esp32
2024-05-21 rajout à code faute de grammaire
2024-05-21 changement du path de conf.py dans .readthedocs.yaml
2024-05-21 changement du version de 1 a 2 dans .readthedocs.yaml
2024-05-21 changement mise en trema de version ubuntu dans .readthedocs.yaml
2024-05-21 changement version ubuntu de 24 a 22 dans .readthedocs.yaml
2024-05-21 changement version python de 3.11.3 a 3.11 dans .readthedocs.yaml
2024-05-21 rajout dans conf.py déplacement de import rtd them
